fpt/tang-verilog/README.md

# tang-verilog

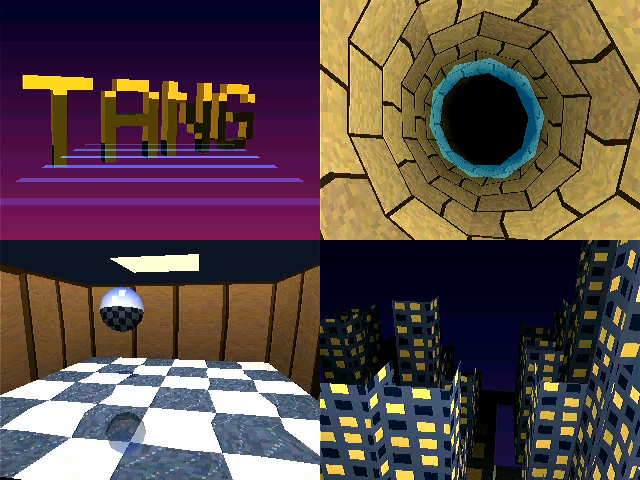
[picture p1: docs/images/g5_scenes.png]
3D GPU のビットストリームで描いた場面 (実機の HDMI キャプチャ): ロゴ、トンネル、映り込む玉の部屋、夜の街


Tang Nano 20K (Gowin GW2AR-18) と RP2350 で、レトロゲーム機の VDP のようなものを作るためのプロジェクトです。

- FPGA 側 (Tang Nano 20K): VDP 本体。今は HDMI (DVI) に 640x480@60Hz の映像を出す
- RP2350 側: ホスト CPU 役。SPI などで VDP にコマンドを送る (予定)

ツールはすべてオープンソースのものを Docker コンテナ内で動かします。ホストに必要なのは Docker と make だけです
(ボードへの書き込みだけは例外です。下の「書き込み」を参照)。

## ドキュメント

- [docs/SPECIFICATION.md](docs/SPECIFICATION.md): アプリケーション開発者向けの仕様 (接続、レジスタ、コマンド、データ形式、タイミング、制限)
- [docs/ARCHITECTURE.md](docs/ARCHITECTURE.md): 設計方針と今の実装 (レジスタバス、レジスタマップ、クロック、SDRAM)
- [docs/GPU_PLAN.md](docs/GPU_PLAN.md): SDRAM フレームバッファの tiny-GPU の開発計画 (ハーネスで検証しながら進める)
- [docs/WIRING.md](docs/WIRING.md): RP2350 と Tang Nano 20K の配線・SPI ピン割り当て
- [docs/DEVELOPMENT.md](docs/DEVELOPMENT.md): 開発環境の補足

## 状態

- 実機 (Tang Nano 20K + HDMI) で、SPI のハーネス (RP2040-Zero) からコマンド GPU (図形・BLIT)、ライン合成、タイル レイヤが動いている。
  すべて 参照モデル = Verilator = 実機 の CRC で確かめている ([docs/HARNESS.md](docs/HARNESS.md))
- 進み具合: コマンド GPU は [docs/GPU_PLAN.md](docs/GPU_PLAN.md) (M0〜M9 済み、M8 はやめた)、エミュレータ向けのタイル/スプライト エンジンは
  [docs/EMU_GPU_PLAN.md](docs/EMU_GPU_PLAN.md) (E1〜E4・E7 (Mode 7 と霧) 済み、次は E5 のホスト翻訳層)、
  [rs-kessel](https://github.com/fpt/rs-kessel) を載せる準備は [docs/KESSEL_ON_VDP.md](docs/KESSEL_ON_VDP.md) (K1〜K4 の VDP 側 = 8bpp の面・BLIT4・スプライトのセル順とバンク・STRETCH_BLIT・ライトマップ済み)
- 3D GPU (タイルベース、VDP を外した別のビットストリーム `make bitstream-gpu3d`。フラッシュに VDP と一緒に置き、`RECONFIG` で入れ替える) は [docs/GPU3D_PLAN.md](docs/GPU3D_PLAN.md) (G0 の骨格、G1 の三角形 (単色・Gouraud・Z)、G2 のタイルベースの遅延描画 (TBDR)、G3 のテクスチャ、G4 の半透明、G5 の場面 (ロゴ・トンネル・映り込む玉の部屋・夜の街、`harness.py demo <場面>`) 済み)
- 本番ホスト (RP2350) とのリンクは HSTX に決めた (EMU_GPU_PLAN.md の「本番のリンク」)。まだ作っていない

## ツール

| 用途 | ツール | 入手元 |
| --- | --- | --- |
| 論理合成 | Yosys + yosys-slang プラグイン (SystemVerilog フロントエンド) | [OSS CAD Suite](https://github.com/YosysHQ/oss-cad-suite-build) |
| 配置配線 | nextpnr-himbaechel (Gowin) | 同上 |
| ビットストリーム生成 | apicula (`gowin_pack`) | 同上 |
| シミュレーション | Icarus Verilog / Verilator / cocotb | 同上 |
| 書き込み | openFPGALoader | 同上 (ただしコンテナからは USB が使えない) |
| RP2350 ファームウェア | arm-none-eabi-gcc + pico-sdk 2.3.1 + picotool | Debian パッケージ / GitHub |

## セットアップ

```bash
make images
```

`docker/fpga` と `docker/pico` の 2 つのイメージを順番にビルドします (`make image-fpga` / `make image-pico` で個別にも可)。
FPGA 側は OSS CAD Suite (約 1GB) をダウンロードするので時間がかかります。
開発環境についての補足は [docs/DEVELOPMENT.md](docs/DEVELOPMENT.md) を参照してください。

### メモリについて

Docker Desktop の割り当てメモリが少ないと、イメージのビルド (特に picotool のコンパイル) でメモリが足りなくなることがあります。
2 つのイメージは並列ではなく 1 つずつビルドしてください。

## 使い方

```bash
make help
```

| コマンド | 内容 |
| --- | --- |
| `make lint` | Verilator で RTL を lint |
| `make sim` | `sim/tb_*.sv` を全部実行 (`SIM=verilator` で Verilator を使う)。VCD は `build/sim/` に出力 |
| `make sim-tb_tmds_encoder` | テストベンチを 1 つだけ実行 |
| `make render` | Verilator で映像出力を回し、各フレームを `build/render/frame_*.png` に保存 |
| `make bitstream` | 合成 → 配置配線 → VDP (`build/vdp/top.fs`) と 3D GPU (`build/gpu3d/top.fs`)。1 つだけなら `make bitstream-vdp` / `bitstream-gpu3d` |
| `make flash` | VDP をフラッシュの 0x000000、3D GPU を 0x100000 に (電源を入れると VDP。`harness.py reconfig` か、要るときに `harness.py` が自分で入れ替える) |
| `make prog` / `make prog-3d` | VDP / 3D GPU を SRAM に (開発中の確かめ) |
| `make bitstream-lcd` | 40 ピン RGB LCD (800x480) に HDMI と同じテストパターンを出す → `build/lcd/top_lcd.fs` (`make prog-lcd` で書き込み) |
| `make scenario SCENARIO=scenarios/m5_basic.json` | GPU のシナリオをシステム全体の RTL (Verilator) で走らせ、参照モデルの CRC と比べる。実機は `harness.py scenario` |
| `make render FREEZE=1` | アニメーションを止めた参照画像と各フレームの CRC (`frames.json`) を `build/render_frozen/` に (実機の `FRAME_CRC` と比べる) |
| `make render-lcd` | LCD 版の映像を `build/render_lcd/frame_*.png` に保存 |
| `make harness-fw` / `python3 tools/harness/harness.py <cmd>` | ハーネスの RP2 ブリッジとホストツール (`status` / `selftest` / `memtest` / `frametest` / `fbtest` / `prog` など)。詳細は [docs/HARNESS.md](docs/HARNESS.md) |
| `make prog` / `make flash` | Tang Nano 20K の SRAM / Flash に書き込み (書く前に、ハーネスのピンと衝突しないかを `pincheck-<設計>` が自動で検査する) |
| `make fw` | RP2350 ファームウェアをビルド (`firmware/build/vdp_host.uf2`) |
| `make shell` / `make shell-pico` | 各コンテナのシェルに入る |
| `make zip` | 別環境へ持っていくためのソース一式を `dist/<ディレクトリ名>.zip` に作成 (ホストの git と zip を使用) |

### 波形を見る

GTKWave は GUI ツールなので、macOS 上の Docker からは簡単には開けません。ローカルに何も入れずに見るなら
[Surfer のブラウザ版](https://app.surfer-project.org/) で `build/sim/*.vcd` を開いてください。

### 書き込み

macOS 上の Docker Desktop のコンテナからは USB デバイスにアクセスできないため、`make prog` だけはホストの `openFPGALoader` を使います。

```bash
brew install openfpgaloader
```

ホストに何も入れたくない場合は、Gowin 公式の Programmer を使う方法もあります。

RP2350 は BOOTSEL ボタンを押しながら USB 接続し、出てきたドライブに `firmware/build/vdp_host.uf2` をコピーすれば書き込めます (ツール不要)。
ボードを変えるときは `make fw PICO_BOARD=<ボード名>`、RISC-V コア (Hazard3) を使うときは `make fw PICO_PLATFORM=rp2350-riscv` です。

## ディレクトリ構成

```
docker/
  fpga/Dockerfile        FPGA ツール (OSS CAD Suite)
  pico/Dockerfile        RP2350 ツール (pico-sdk, picotool)
rtl/
  vdp/                   ベンダ非依存の RTL (シミュレーション可能)
    video_timing.sv      640x480@60Hz のタイミング生成
    vdp_core.sv          VDP コアの雛形 (カラーバー + 市松模様 + 跳ね回る四角)
    tmds_encoder.sv      DVI の TMDS エンコーダ
    vdp_video.sv         タイミング + コアをまとめたもの (MODE 0: 640x480 HDMI / 1: 800x480 LCD)
  gowin/                 Gowin のプリミティブを使う部分
    dvi_tx.sv            OSER10 + TLVDS_OBUF による DVI 送信
    top.sv               トップ (rPLL 126MHz → CLKDIV /5 → 25.2MHz)
    top_lcd.sv           RGB LCD 版トップ (rPLL 33MHz、800x480)
    blackbox/            Gowin プリミティブのブラックボックス定義 (合成専用)
constraints/
  tangnano20k.cst        ピン配置 (HDMI)
  tangnano20k_lcd.cst    ピン配置 (40 ピン RGB LCD)
sim/
  tb_*.sv                テストベンチ (Icarus Verilog / Verilator)
  verilator/render_main.cpp  フレームを画像に書き出すシミュレータ
firmware/                RP2350 ファームウェア (pico-sdk)
scripts/
  ppm2png.py             PPM → PNG 変換
```

## ハードウェアメモ (Tang Nano 20K)

| 信号 | ピン |
| --- | --- |
| 27MHz クロック | 4 |
| ボタン S1 / S2 (押下で 1) | 88 / 87 |
| LED0〜5 (負論理) | 15〜20 |
| HDMI CLK / D0 / D1 / D2 (P,N) | 33,34 / 35,36 / 37,38 / 39,40 |

- デバイス: `GW2AR-LV18QN88C8/I7` (nextpnr の family は `GW2A-18C`)
- 40 ピン RGB LCD の R/G 信号の一部 (33〜40) は HDMI と同じピンなので、HDMI と LCD は同時には使えません (別の `TARGET`)
- ピクセルクロックは 25.2MHz で、規格値の 25.175MHz からわずかにずれています (たいていのモニタは問題なく表示します)
