fpt/tang-verilog/docs/SPECIFICATION.md

# VDP 仕様書 (アプリケーション開発者向け)

Tang Nano 20K の VDP を、ホスト (RP2350 など) のプログラムから使うための仕様。[rs-kessel](https://github.com/fpt/rs-kessel) の VDP バックエンドなど、
コマンド列を作る側が参照することを想定している。設計の経緯は [ARCHITECTURE.md](ARCHITECTURE.md)、Kessel との対応は [KESSEL_ON_VDP.md](KESSEL_ON_VDP.md)。

この文書は E7 (Mode 7 と霧) までの RTL に合わせてある。正確な定義は RTL の先頭のコメント
([`gpu.sv`](../rtl/vdp/gpu.sv)、[`line_compositor.sv`](../rtl/vdp/line_compositor.sv)、[`tile_layer.sv`](../rtl/vdp/tile_layer.sv)、[`mode7_layer.sv`](../rtl/vdp/mode7_layer.sv)、
[`sprite_layer.sv`](../rtl/vdp/sprite_layer.sv)、[`vdp_regs.sv`](../rtl/vdp/vdp_regs.sv)) と、参照モデル [`gpu_model.py`](../tools/harness/gpu_model.py)。
食い違いがあれば RTL が正しい。参照モデルは RTL と同じ画をピクセル単位で作る (CRC が一致する) ので、ホスト側のテストの期待値に使える。

## 目次

1. 概要
2. ホストとの接続 (SPI)
3. レジスタ
4. コマンド
5. 合成のレジスタ (`REG_WRITE`)
6. データ形式
7. 合成 (レイヤと順位)
8. タイミング
9. 制限
10. 1 フレームの組み立て方
11. 検証の手がかり
12. 音 (PCM)
13. Mode 7 と霧
14. 3D GPU (別のビットストリーム)

---

## 1. 概要

- 論理画面は **320 x 240**。出力は縦横 2 倍の 640 x 480 @ 60Hz (HDMI / DVI)
- レイヤ: 背景色、**ビットマップ** (SDRAM のフレームバッファ 2 枚、RGB565 か 8bpp)、**タイルの面 A / B** とウィンドウ、**スプライト** 128 個。
  面 A は **Mode 7** (回転・拡大・遠近、13 章) にもできる。出力には行ごとの倍率と加算 (**霧**、フェード) を掛けられる
- ホストはレイヤのレジスタを書き、VRAM・パレット・OAM を書き、フレームバッファに**コマンドで描く**。VDP がピクセルを直接受け取ることはない
- 合成はライン単位。レジスタは**ラインの合成を始めるときに取り込む**ので、`WAIT_LINE` のあとのレジスタの変更はそのラインから効く (ラスター効果)

```text
ホスト ──SPI──► レジスタ ──► コマンド FIFO (512 ワード) ──► GPU ──► SDRAM (フレームバッファ・アセット)
                                                        │
                                                        ├──► VRAM (64KiB) / パレット (512 色) / OAM (128 個)
                                                        └──► 合成のレジスタ ──► ライン合成 ──► 640x480 出力
```

| 資源 | 大きさ | 書き方 |
| --- | --- | --- |
| SDRAM | 8MiB (2M ワード x 32bit) | `UPLOAD`、描くコマンド |
| VRAM | 16K ワード x 32bit (64KiB) | `VRAM_WRITE` |
| パレット | 512 エントリ x RGB565 | `PAL_WRITE` |
| OAM | 128 エントリ x 2 ワード | `OAM_WRITE` |
| ライトマップ | 40 x 30 セル (8 x 8 ピクセルごと) x RGB の倍率 | `LIGHT_WRITE` |
| 音 | 48kHz ステレオ 16bit、SDRAM の PCM のリング → 基板のアンプ (MAX98357A) | `UPLOAD` + `REG_WRITE` (12 章) |

ホストから SDRAM・VRAM・パレット・OAM を読み返す方法はない (SDRAM の 1 ワード読み出しはテスト用のレジスタにあるが、アプリケーションでは使わない)。

## 2. ホストとの接続 (SPI)

今のリンクは SPI。本番では HSTX (片方向の 4 ビット DDR) を足す予定で、そのときもコマンドの形式は同じ ([HARNESS2.md](HARNESS2.md))。

| 項目 | 値 |
| --- | --- |
| モード | mode 0 (CPOL 0, CPHA 0)、MSB first、8bit |
| CS | **正論理** (High で選択) |
| クロック | 8MHz まで実機で確認。FPGA が 63MHz でサンプリングするので上限は 10MHz 程度 |
| 電圧 | 3.3V |

配線は [WIRING.md](WIRING.md) (v1) と [HARNESS2.md](HARNESS2.md) (v2)。

### トランザクション

```text
書き込み: CS↑ [0 | addr(7)] [data] [data] ... CS↓     2 バイト目以降は addr, addr+1, ... へ
読み出し: CS↑ [1 | addr(7)] [xx]   [xx]   ... CS↓     2 バイト目以降に addr, addr+1, ... の値が返る
```

- **`0x30`〜`0x3F` はアドレスが進まない** (ポート)。`0x30` (`CMD`) には 1 回のトランザクションで何バイトでも続けて書ける
- 1 バイト目のあいだ、CIPO には同期確認用の `0xA5` が出る
- CS がバイトの途中で下がると `STATUS` のエラーが立つ (そのバイトは捨てられる)

### ほかの線

| 線 | 向き | 意味 |
| --- | --- | --- |
| IRQ | VDP → ホスト | 既定は VBLANK (`CONTROL` bit2 で有効)。`CONTROL` bit4 で **READY** (コマンド FIFO が半分以上空いている) に切り替わる。FPGA が未コンフィグのときは High に見える |
| VSYNC | VDP → ホスト | 垂直同期 (正論理、パルス中 High)。60Hz |
| HEARTBEAT | VDP → ホスト | フレームごとにトグル (30Hz)。リセット中は止まる。「FPGA が動いている」の判定に使う |
| RESET | ホスト → VDP | High でリセット (正論理)。全レジスタが既定に戻る。SDRAM・VRAM・パレット・OAM の中身は保証しない |

**IRQ / READY を信じる前に HEARTBEAT のトグル (か `ID` = `0x5A`) を確かめる** (未コンフィグ時やビットストリームの書き込み中も High なので)。

## 3. レジスタ

複数バイトの値はリトルエンディアン。

### システム (`vdp_regs`)

| アドレス | 名前 | R/W | 内容 |
| --- | --- | --- | --- |
| `0x00` | `STATUS` | R | bit0: VBLANK 中、bit1: エラー (SPI のフレームエラーなど。読むとクリア) |
| `0x01` | `CONTROL` | RW | bit2: IRQ 許可 (IRQ = VBLANK)、**bit3: 合成した画面を表示 (0 ならテストパターン)**、bit4: IRQ ピンを READY にする。bit0, bit1 は予約 (0 を書く)。既定 0 |
| `0x02` | `MARK_COUNT` | R | `MARK_CRC` を更新するたびに 1 増える |
| `0x04` | `FRAME_COUNT` | R | フレームカウンタの下位 8bit |
| `0x05`〜`0x08` | `FRAME_CRC` | R | 直前のフレームの表示の CRC-32 (11 章)。`0x05` を読んだ時点の値を取っておくので、`0x05` から 4 バイト続けて読む |
| `0x09` | `UNDERFLOW` | R | 合成が表示に間に合わなかったライン数 (飽和) |
| `0x0A`〜`0x0B` | `CRC_FRAME` | R | `FRAME_CRC` がリセットから何フレーム目の値か |
| `0x0C`〜`0x0F` | `MARK_CRC` | R | 印を付けたフレーム (`WAIT_VBLANK` の印) の CRC-32 |
| `0x7C` | `RECONFIG` | W | `0xA5` を書くと FPGA を再コンフィグする (設計が RECONFIG_N を Low にする)。フラッシュの multiboot で VDP (0x000000) と 3D GPU (0x100000) が入れ替わる。約 1.7 秒。ほかの値は何もしない |
| `0x7D` | `SCRATCH` | RW | 書いた値がそのまま読める (リンクの確認用) |
| `0x7E` | `ID` | R | `0x5A` |
| `0x7F` | `VERSION` | R | RTL の版 |

**起動したら `CONTROL` に `0x08` (READY を使うなら `0x18`) を書く。** 既定 (0) ではテストパターンが出ている。

`0x10`〜`0x2F` は SDRAM のテスト用 (アプリケーションでは触らない)。

### 音 (`audio_out`、読み出しだけ)

| アドレス | 名前 | R/W | 内容 |
| --- | --- | --- | --- |
| `0x50`〜`0x51` | `PCM_RD` | R | 再生した標本の数 (16bit で回る)。`0x50` を読んだ時点の値を取っておくので、`0x50` から 2 バイト続けて読む |
| `0x52` | `UNDERRUN` | R | 鳴らすときにデータがなく無音を出した標本の数 (飽和する。`AUDIO_CTRL` の clear で 0) |

### GPU (`gpu`)

| アドレス | 名前 | R/W | 内容 |
| --- | --- | --- | --- |
| `0x30` | `CMD` | W | コマンドのポート。書いたバイトを 4 つずつ (リトルエンディアン) 1 ワードにして FIFO に入れる |
| `0x40` | `GPU_STATUS` | R | bit0: 実行中 (FIFO にワードがある / コマンドを実行している)、bit1: エラー (知らないコマンドなど。読むとクリア)、bit2: FIFO があふれた (読むとクリア) |
| | | W | bit0 に 1: FIFO とワードの組み立てを空にする (実行中のコマンドはそのまま) |
| `0x41`〜`0x42` | `GPU_FREE` | R | FIFO の空き (ワード数)。ホストはこの数 x 4 バイトまで送ってよい |
| `0x44`〜`0x45` | `FB_BASE` | RW | 表示する面の先頭 (1KiB 単位、13bit)。既定 0 |
| `0x46`〜`0x47` | `DRAW_BASE` | RW | 描く面の先頭 (同じ単位)。既定 256 (= バイト `0x040000`) |
| `0x48`〜`0x49` | `BG_COLOR` | RW | 背景色 (RGB565) |
| `0x4A` | `LAYER_CTRL` | RW | 5 章と同じ |
| `0x4C`〜`0x4D` | `BITMAP_KEY` | RW | 5 章と同じ |

`BG_COLOR` `LAYER_CTRL` `BITMAP_KEY` はホストから直接も書けるが、ラインに合わせたいときはコマンドの `REG_WRITE` を使う (FIFO の順に効く)。

### 流量の制御

FIFO は 512 ワード。あふれたワードは捨てられ、`GPU_STATUS` bit2 が立つ。どちらかで制御する:

- **READY の線** (`CONTROL` bit4): High のあいだは 256 ワードまで送ってよい (High = 空きが半分以上)
- **`GPU_FREE` を読む**: 読んだ空き x 4 バイトまで送る

`WAIT_LINE` / `WAIT_VBLANK` / `SWAP` で GPU が待っているあいだも FIFO には積める。1 フレーム分 (目安 512 ワード以下) を先に送っておくと、
`WAIT_LINE` のあとの `REG_WRITE` が遅れない (8 章)。

## 4. コマンド

コマンドは 32bit ワードの列。先頭ワードの `[31:24]` がコマンド番号、引数のワードが続く。座標の組は `{y[15:0], x[15:0]}` (下位が x)。
FIFO の順に 1 つずつ実行する (描くコマンドも `WAIT_LINE` も同じ列に並ぶ)。

| 番号 | コマンド | ワード数 | 概要 |
| --- | --- | --- | --- |
| `0x00` | `NOP` | 1 | 何もしない |
| `0x01` | `CLEAR` | 1 | 描く面の全体を塗る |
| `0x02` | `FILL_RECT` | 3 | 矩形を塗る |
| `0x03` | `SWAP` | 1 | 表示する面と描く面を入れ替える |
| `0x04` | `UPLOAD` | 2 + n | SDRAM に n ワード書く |
| `0x05` | `POINT` | 2 | 1 ピクセル |
| `0x06` | `DRAW_LINE` | 3 | 線 |
| `0x07` | `CLIP` | 3 | クリップ矩形 |
| `0x08` | `BLIT` | 5 | SDRAM の画像を描く面に写す (8bpp では 4bpp のソースも) |
| `0x09` | `REG_WRITE` | 1 | 合成のレジスタ (5 章) |
| `0x0A` | `WAIT_LINE` | 1 | ライン n まで待つ |
| `0x0B` | `WAIT_VBLANK` | 1 | 次のフレームのライン 0 まで待つ (印を付けられる) |
| `0x0C` | `VRAM_WRITE` | 2 + n | VRAM に n ワード |
| `0x0D` | `PAL_WRITE` | 2 + ⌈n/2⌉ | パレットに n 色 |
| `0x0E` | `STRETCH_BLIT` | 7 | `BLIT` の拡大縮小版 (最近傍) |
| `0x0F` | `OAM_WRITE` | 2 + n | OAM に n ワード |
| `0x10` | `LIGHT_WRITE` | 2 + n | ライトマップに n セル |
| ほか | — | 1 | エラーを立て、1 ワードのコマンドとして読み飛ばす |

### 色

描くコマンドの色は、面の形式 (`BITMAP_FMT`、5 章) で意味が変わる。

- **RGB565** (`BITMAP_FMT` = 0): `[15:0]` が RGB565 の色
- **8bpp** (`BITMAP_FMT` = 1): `[7:0]` がパレットの番号 (0..255)。`[15:8]` は無視 (`BLIT` の 4bpp では `[11:8]` がバンク)

`BITMAP_FMT` は描くコマンドには**すぐ**効く。面の中身の形式を覚えているわけではないので、描くときと表示するときの形式をホストが揃える。

### 各コマンド

**`CLEAR`** `[0x01, -, color]`
描く面の 320 x 240 全体を塗る。**クリップ矩形は効かない。**

**`FILL_RECT`** `[0x02, -, color]` `{y, x}` `{h, w}`
x, y, w, h は**符号なし**。画面の外にはみ出した部分とクリップ矩形の外は描かない。w = 0 か h = 0 なら何もしない。
画面の外 (負の座標) から始まる矩形は、ホストが切ってから送る。

**`SWAP`** `[0x03]`
`FB_BASE` と `DRAW_BASE` を入れ替える。表示側が新しい `FB_BASE` を取り込む (次のフレームのライン 0 の合成を始める) まで、**後続のコマンドを待たせる**。
なので `SWAP` のあとのコマンドは、前の表示面 (= 新しい描く面) を安全に描ける。

**`UPLOAD`** `[0x04, n(24bit)]` `addr` `data × n`
SDRAM のワードアドレス `addr` (21bit) から n ワード書く。1 ワードずつ書くので速くない (8 章)。アセットは起動時にまとめて送る。

**`POINT`** `[0x05, -, color]` `{y, x}`
x, y は**符号付き** 16bit。クリップ矩形の中なら 1 ピクセル描く。

**`DRAW_LINE`** `[0x06, -, color]` `{y0, x0}` `{y1, x1}`
符号付き。ブレゼンハムで両端を含めて描く。画面の外から始まる線もよい (クリップ矩形の外のピクセルは飛ばす)。
傾きの規則は `err = dx + dy` (dy は負)、`e2 = 2 err`、`e2 >= dy` で x、`e2 <= dx` で y を進める (参照モデルの `bresenham()`)。

**`CLIP`** `[0x07]` `{y0, x0}` `{y1, x1}`
符号なし、両端を含む。以降の `FILL_RECT` `POINT` `DRAW_LINE` `BLIT` をこの矩形の中だけにする。画面の外は画面の端に丸める。
x0 > x1 などなら何も描かなくなる。既定は画面全体 (`0,0`〜`319,239`)。

**`BLIT`** `[0x08, flags(8), key(16)]` `src` `{h, w}` `{y, x}` `stride`
SDRAM のワードアドレス `src` にある w x h の画像を、描く面の (x, y) (符号付き) に写す。`stride` はソースの 1 行のワード数 (下位 16bit)。

| flags | 意味 |
| --- | --- |
| bit0 | 透過: 透過色 (下) のピクセルを書かない |
| bit1 | 左右反転 |
| bit2 | 上下反転 |
| bit3 | 4bpp のソース (BLIT4)。**8bpp のときだけ**。RGB565 で立てるとエラーになり何も描かない |

| 面の形式 | ソース | 1 ワードのピクセル | 書く値 | 透過色 |
| --- | --- | --- | --- | --- |
| RGB565 | RGB565 | 2 (下位 16bit が左) | そのまま | `key` (RGB565) |
| 8bpp | 8bpp | 4 (バイト i がピクセル i) | そのまま | `key[7:0]` |
| 8bpp | 4bpp (bit3) | 8 (ピクセル i は `[31-4i -: 4]`) | `{key[11:8], ピクセル}` | 値 0 |

- ソースの各行は**ワードの先頭から始まる** (行の途中のピクセルから切り出すときは、`src` をワード単位で、左端をワードの境目に揃える)
- w は 512 まで (越えるとエラー)。h は 240 を越えてもよい (はみ出しは描かない)
- 4bpp のソースはタイルの 1 行と同じ並び。タイルのシート (6 章) を SDRAM に `UPLOAD` すれば、タイル t は `src = base + 8t`、`stride = 1`、`w = h = 8`
- ソースは SDRAM だけ。VRAM・描く面と重なるソースの動きは決めていない (重ねない)
- クリップ矩形と画面の外は描かない

**`STRETCH_BLIT`** `[0x0E, flags(8), key(16)]` `src` `{dh, dw}` `{y, x}` `{sw, stride}` `sx_step` `sy_step`
SDRAM の画像を拡大縮小して、描く面の (x, y) (符号付き) に dw x dh で描く (最近傍)。flags・key・ソースの形式・透過・クリップは `BLIT` と同じ。

- `sw` はソースの幅 (ピクセル、ソースの 1 行を読む長さ)、`stride` は 1 行のワード数
- `sx_step` / `sy_step` は 16.16 の固定小数点で、描く 1 ピクセルあたりのソースのピクセル数 (= ソースの大きさ / 描く大きさ。**割り算はホストが行う**)
- 描くピクセル (i, j) (反転の前、0 から) が拾うソースは、列 `((sx_step >> 1) + i * sx_step) >> 16`、行 `((sy_step >> 1) + j * sy_step) >> 16`
  (32bit で計算する。半ピクセルずらしてピクセルの中心で拾うので、縮小で片寄らない)。左右反転は描く列を右から、上下反転は描く行を下から並べる
- **拾うソースの列は `sw` より小さくなるように step を選ぶ** (`sx_step = sw * 65536 / dw` の切り捨てなら必ず収まる)。越えたときの値は決まっていない。
  行は `stride` で進むだけなので、ソースの高さはホストが守る
- 上限: dw, dh は 1024 まで。`sw` はソースの 1 行が 256 ワードに収まる大きさまで (RGB565 で 512、8bpp で 1024、4bpp で 2048)。越えるとエラーで何も描かない
- クリップの外の行は読まない (その分速い)。同じソースの行が続く (拡大する) ときは読み直さない
- Kessel の `spr_scaled(id, x, y, scale)` は、タイル t を `src = base + 8t`、`stride` 1、`sw` 8、`dw = dh = 8 * scale` (切り捨て)、`step = 8 * 65536 / dw` の 4bpp の `STRETCH_BLIT` にする

**`REG_WRITE`** `[0x09, reg(8), value(16)]`
合成のレジスタ `reg` に値を書く (5 章)。知らない番号はエラー。

**`WAIT_LINE`** `[0x0A, -, n(8)]`
以降のコマンドを、ライン n の合成が始まる直前 (ライン n-1 の合成が始まったところ) まで待たせる。
**これより後の `REG_WRITE` はライン n から効く。** n = 0 は `WAIT_VBLANK` と同じ。n は 0..239。
すでにライン n を過ぎていたら、次のフレームのライン n まで待つ。

**`WAIT_VBLANK`** `[0x0B, -, mark(1)]`
`WAIT_LINE 0` と同じ: ライン 239 の合成が始まった直後まで待つ (以降の `REG_WRITE` は次のフレームのライン 0 から効く)。
そこからライン 0 の合成までは約 1.5ms (8 章)。
`[0]` = 1 なら次のフレームに印を付け、その CRC を `MARK_CRC` に残す (11 章)。

**`VRAM_WRITE`** `[0x0C, n(24)]` `addr` `data × n`
VRAM のワードアドレス `addr` から n ワード (16K ワードで折り返す)。1 クロック 1 ワード。

**`PAL_WRITE`** `[0x0D, n(24)]` `index` `data × ⌈n/2⌉`
パレットの `index` (0..511) から n 色。1 ワードに 2 色 (下位 16bit が先)。n が奇数なら最後のワードの上位は使わない。512 で折り返す。

**`OAM_WRITE`** `[0x0F, n(24)]` `addr` `data × n`
OAM のワードアドレス `addr` (エントリ k はワード 2k と 2k+1) から n ワード (256 ワードで折り返す)。形式は 6 章。

**`LIGHT_WRITE`** `[0x10, n(24)]` `addr` `data × n`
ライトマップのセル `addr` (= `cy * 40 + cx`) から n セル (2048 で折り返す。1,200 以上は使われない)。1 ワードに 1 セル:
`[5:0]` R、`[13:8]` G、`[21:16]` B の倍率 (0..63、16 = 1 倍)。全体は 1 回の `LIGHT_WRITE` (1,200 ワード) で書ける。使い方は 7 章の「ライトマップ」。

VRAM・パレット・OAM・ライトマップの書き込みは**すぐ**効く (ラインに合わせない)。表示中に書くと、そのフレームの途中から変わる (8 章)。

## 5. 合成のレジスタ (`REG_WRITE`)

どれもラインの合成を始めるときに取り込む。値は各レジスタの幅に切る。

| 番号 | 名前 | 幅 | 既定 | 内容 |
| --- | --- | --- | --- | --- |
| 0 | `BG_COLOR` | 16 | 0 | 背景色 (**RGB565**、パレットの番号ではない)。どのレイヤも書かなかったピクセルの色 |
| 1 | `LAYER_CTRL` | 6 | 1 | bit0: ビットマップ、bit1: ビットマップの透過色を有効、bit2: 面 A (とウィンドウ)、bit3: スプライト、bit4: 面 B、bit5: ライトマップを掛ける |
| 2 | `BITMAP_KEY` | 16 | 0 | ビットマップの透過色。RGB565 の面では色、8bpp の面では `[7:0]` がパレットの番号 |
| 3 | `TILE_SCROLL_X` | 10 | 0 | 面 A の横スクロール (ピクセル) |
| 4 | `TILE_SCROLL_Y` | 10 | 0 | 面 A の縦スクロール |
| 5 | `TILE_MAP_BASE` | 14 | 0 | 面 A のマップの VRAM のワードアドレス |
| 6 | `TILE_PAT_BASE` | 14 | 0 | 面 A (とウィンドウ) のタイルの VRAM のワードアドレス |
| 7 | `TILE_CTRL` | 8 | 0 | 面 A の設定 (6 章の「面の設定」) |
| 8 | `BITMAP_RANK` | 3 | 1 | ビットマップの順位 (7 章)。0 なら書かない |
| 9 | `SPR_PAT_BASE` | 14 | 0 | スプライトのタイルの VRAM のワードアドレス |
| 10 | `SPR_BANK` | 4 | 0 | `[2:0]` スプライトのパレットのバンク (64 色単位)。`[3]` = 1 ならスプライトごとのバンク (OAM ワード 1 の `[19:16]`) を使う |
| 11 | `SPR_LINE_PX` | 10 | 320 | 1 ラインのスプライトのピクセル数の上限 (8 の倍数に切り捨て) |
| 12〜16 | `TILEB_SCROLL_X` `TILEB_SCROLL_Y` `TILEB_MAP_BASE` `TILEB_PAT_BASE` `TILEB_CTRL` | | 0 | 面 B (面 A と同じ形) |
| 17 | `WIN_H` | `[7]`, `[4:0]` | 0 | ウィンドウの横: `[7]` = 1 なら右側、位置 = `[4:0]` x 16 ピクセル |
| 18 | `WIN_V` | `[7]`, `[4:0]` | 0 | ウィンドウの縦: `[7]` = 1 なら下側、位置 = `[4:0]` x 8 ライン |
| 19 | `WIN_MAP_BASE` | 14 | 0 | ウィンドウのマップ (64 x 32、スクロールしない) |
| 20 | `HSCROLL_MODE` | 2 | 0 | 横スクロールの表: 0 なし (レジスタ)、1 画面全体、2 8 ラインごと、3 ラインごと |
| 21 | `HSCROLL_BASE` | 14 | 0 | 横スクロールの表の VRAM のワードアドレス |
| 22 | `BITMAP_FMT` | 1 | 0 | ビットマップの形式: 0 = RGB565、1 = 8bpp。描くコマンドにはすぐ、表示には次のラインから |
| 23 | `AUDIO_CTRL` | 2 | 0 | `[0]` 音を出す (アンプも有効)、`[1]` に 1: `PCM_RD`・`UNDERRUN`・先読みを空にする (12 章) |
| 24 | `PCM_BASE` | 13 | `0x1FE0` | PCM のリングの SDRAM の先頭 (256 ワード = 1KiB 単位)。既定は SDRAM の最後の 32KiB |
| 25 | `PCM_SIZE` | 4 | 11 | リングの大きさ = `1 << n` ワード (標本) |
| 26 | `PCM_WR` | 16 | 0 | ホストが書いた標本の数 (16bit で回る)。`UPLOAD` のあとに書く |

| 32〜50 | `M7_SEL` 〜 `LINE_FX_BASE` | | | Mode 7 と霧 (13 章) |

23〜26 はラインに合わせず、実行したときに効く。ほかの番号 (27〜31、51〜) はエラー。

### ウィンドウ

メガドラと同じ規則。ラインが縦の範囲 (`WIN_V`: 下側なら `line >= 位置`、上側なら `line < 位置`) に入ればライン全体がウィンドウ、
入らなければ横の範囲 (`WIN_H`: 右側なら `x >= 位置`、左側なら `x < 位置`) だけ。ウィンドウの中では面 A を描かず、代わりに
`WIN_MAP_BASE` の 64 x 32 のマップをスクロールなしで描く。タイルの場所・パレットのバンク・エントリの並びは面 A のもの、順位も面 A と同じ。
`WIN_H` = `WIN_V` = 0 ならウィンドウなし。

### 横スクロールの表

`HSCROLL_MODE` が 0 でなければ、ラインごとに VRAM の `HSCROLL_BASE + 番号` の 1 ワードを読み、`[25:16]` を面 A、`[9:0]` を面 B の値にする。
番号はモード 1: 0、2: `line & ~7`、3: `line`。**値の向きはメガドラと同じで、正の値で面が右に動く** (`scroll_x = -値`)。
このとき `TILE_SCROLL_X` / `TILEB_SCROLL_X` は使わない (縦スクロールはレジスタのまま)。

## 6. データ形式

### フレームバッファ (SDRAM)

1 ラインは SDRAM の 1 行 (256 ワード = 1KiB) に置く。面の先頭を `base` (1KiB 単位) とすると、ライン y はワードアドレス `(base + y) * 256` から。

| 形式 | 1 ワードのピクセル | ピクセル x の場所 | 1 ラインのワード数 |
| --- | --- | --- | --- |
| RGB565 | 2 | ワード `x / 2` の `[16 (x % 2) +: 16]` | 160 |
| 8bpp | 4 | ワード `x / 4` の `[8 (x % 4) +: 8]` | 80 |

RGB565 は `{R[4:0], G[5:0], B[4:0]}`。8bit への広げ方は上位ビットの繰り返し (`R8 = {R5, R5[4:2]}` など)。

SDRAM の使い方 (決まりではなく既定の値):

| バイトアドレス | 用途 |
| --- | --- |
| `0x000000` | 面 0 (`FB_BASE` の既定 0) |
| `0x040000` | 面 1 (`DRAW_BASE` の既定 256) |
| `0x080000`〜 | 空き (アセット: BLIT のソース、4bpp のタイルのシートなど) |
| `0x7F8000`〜`0x7FFFFF` | 音の PCM のリング (`PCM_BASE` の既定。2048 標本なら 8KiB) |

ワードアドレスは 21bit (`0`〜`0x1FFFFF`)。面は 240 行 = 240KiB を使う。

### パレット

512 エントリ x RGB565。全レイヤで共有する。

| 使う側 | 番号 |
| --- | --- |
| タイルの面 | `{TILE_CTRL[6:4] (バンク), エントリのパレット (2bit), ピクセルの値 (4bit)}` = バンク x 64 + パレット x 16 + 値 |
| スプライト | `{SPR_BANK[2:0], エントリのパレット (2bit), ピクセルの値}`。`SPR_BANK[3]` = 1 なら `{0, スプライトのバンク (4bit), ピクセルの値}` (0..255、8bpp・BLIT4 と同じ番号) |
| 8bpp のビットマップ | 0..255 (ピクセルの値そのまま) |
| BLIT4 | 描く値 `{バンク (4bit), ピクセル}` が 8bpp の番号になる (0..255) |

### タイル (VRAM)

8 x 8 ピクセル、4bpp。1 行が 1 ワードで、**ピクセル i (左から) は `[31-4i -: 4]`** (上位のニブルが左)。タイル t の行 r はワード `pat_base + 8t + r`。
ピクセルの値 0 は透明。タイル番号は 11bit (0..2047)。VRAM は 16K ワードなので、マップと合わせて 64KiB に収める。

同じ形式のデータを SDRAM に置けば BLIT4 のソースになる (タイル 1 個 = 8 ワード、stride 1)。

### マップのエントリ (面 A / B / ウィンドウ)

16bit、1 ワードに 2 つ。

| ビット | 意味 |
| --- | --- |
| `[10:0]` | タイル番号 |
| `[11]` | 左右反転 |
| `[12]` | 上下反転 |
| `[14:13]` | パレット (0..3) |
| `[15]` | 優先度 (7 章) |

列 c、行 r のエントリは `map_base + (r * 幅 + c) / 2` の、偶数の列なら下位 16bit (面の設定 `[7]` = 1 なら上位 = メガドラの並び)。

### 面の設定 (`TILE_CTRL` / `TILEB_CTRL`)

| ビット | 意味 |
| --- | --- |
| `[1:0]` | マップの幅: 0 = 32、1 = 64、2 = 128 タイル |
| `[3:2]` | 高さ: 0 = 32、1 = 64、2 = 128、3 = 28 タイル (このときは scroll_y < 224) |
| `[6:4]` | パレットのバンク (64 色単位) |
| `[7]` | エントリの並び: 0 = 下位が偶数の列、1 = 上位が偶数の列 (メガドラの VRAM をビッグエンディアンの 32bit で読んだ並び) |

画面のピクセル (x, line) は、マップのピクセル `((x + scroll_x) mod 幅, (line + scroll_y) mod 高さ)`。**面は折り返して画面全体を覆う**。

### OAM (スプライト)

128 エントリ、エントリ n はワード 2n (ワード 0) と 2n+1 (ワード 1)。

| ワード | ビット | 意味 |
| --- | --- | --- |
| 0 | `[9:0]` | x (符号付き 10bit、画面の左端が 0) |
| 0 | `[25:16]` | y (符号付き 10bit) |
| 0 | `[27:26]` | 幅 - 1 (タイル、1〜4) |
| 0 | `[29:28]` | 高さ - 1 (タイル、1〜4) |
| 0 | `{[10], [30]}` | セルの並び順 (下) |
| 0 | `[31]` | 有効 |
| 1 | `[15:0]` | マップのエントリと同じ形 (先頭のタイル、左右反転、上下反転、パレット、優先度) |
| 1 | `[19:16]` | スプライトごとのバンク (`SPR_BANK[3]` = 1 のときだけ使う。そのときエントリのパレット `[14:13]` は使わない) |

ほかのビット (ワード 0 の `[15:11]`、ワード 1 の `[31:20]`) は 0 にする (将来使う)。

セルの並び順 (スプライトの中の列 c、行 r のタイル):

- 0: 列優先 (メガドラ) — `先頭 + c * 高さ + r`
- 1: 16 タイル幅の表 (SNES) — `{先頭[10:4] + r, 先頭[3:0] + c}` (列は表の行の中で折り返す)
- 2: 行優先、ストライドはスプライトの幅 (Kessel の `sprn`) — `先頭 + r * 幅 + c`
- 3: 予約 (今は 2 と同じ。使わない)

左右反転はタイルの列の順番とタイルの中のピクセルの両方を、上下反転は行の順番とタイルの中の行の両方を逆にする。

## 7. 合成 (レイヤと順位)

ピクセルごとに、順位の一番高いレイヤの色が出る。どのレイヤも書かなかったところは `BG_COLOR`。

| 順位 | レイヤ |
| --- | --- |
| 0 | 背景色 |
| 1 | 面 B (低優先) |
| 2 | 面 A (低優先) とウィンドウ。Mode 7 (EXTBG なら `[7]` が 0 のピクセル) |
| 3 | スプライト (低優先) |
| 4 | 面 B (高優先) |
| 5 | 面 A (高優先) とウィンドウ。Mode 7 の EXTBG で `[7]` が 1 のピクセル |
| 6 | スプライト (高優先) |
| `BITMAP_RANK` | ビットマップ (0〜7) |

- 優先度はタイルのエントリ / OAM の `[15]`
- **同じ順位なら、先に書いたほうが残る**。書く順は スプライト → 面 B → 面 A → ウィンドウ → ビットマップ。
  なので `BITMAP_RANK` = 6 は、すべての面より上で、高優先のスプライトより下 (低優先のスプライトよりは上) になる
- スプライト同士は優先度によらず **OAM の前のエントリが勝つ** (メガドラ・SNES と同じ)
- タイル・スプライトのピクセルの値 0 は透明。ビットマップは `LAYER_CTRL` bit1 が立っているとき、透過色 (`BITMAP_KEY`) のピクセルが透明

よく使う組み合わせ:

| 狙い | 設定 |
| --- | --- |
| 面の上に即時描画、その上にハードスプライト (Kessel の 3 段) | `BITMAP_RANK` = 6、透過あり、スプライトは高優先 |
| ビットマップを一番上 (HUD) | `BITMAP_RANK` = 7 |
| ビットマップを一番下 (背景画) | `BITMAP_RANK` = 1 (既定)、面は透明なところから下が見える |

### ライトマップ

`LAYER_CTRL` bit5 が立っているラインでは、合成した色 (背景色を含む、レイヤによらず全部) に、ピクセル (x, y) のセル `(x / 8, y / 8)` の倍率を掛ける。
各色 c (R5・G6・B5) と倍率 L (0..63) について `min(最大値, (c * L) >> 4)`。L = 16 で元の色、0 で黒、32 で 2 倍 (最大値で切れる)。

- セルの解像度は 8 ピクセル。光の境目はセルの境目で段になる (補間はしない)
- 倍率は R, G, B で別々なので、色の付いた光 (`light(…, r, g, b)`) もそのまま表せる
- Kessel の倍率 (64 = 1 倍、8bit) からは `>> 2` で直す
- ラインごとに切り替えられる (HUD の行だけ光なし、など)。合成の時間は増えない
- 行の倍率 `LINE_MUL` と加算 `LINE_ADD` (霧、13 章) と同じ段で掛かる。倍率はセルの倍率 x 行の倍率 (63 で切る)

## 8. タイミング

### 映像

| 項目 | 値 |
| --- | --- |
| 出力 | 640 x 480 @ 60Hz (ピクセルクロック 25.2MHz)、1 フレーム 525 ライン x 800 クロック = 16.67ms |
| 論理ライン | 出力 2 ライン = 63.5us |
| VBLANK | 出力ライン 480〜524 (45 ライン = 1.43ms)。`STATUS` bit0、IRQ |
| GPU・SDRAM のクロック | 63MHz |

### 合成

- 論理ライン n は、ライン n-1 を表示しているあいだ (63.5us = 63MHz で 4,000 クロック) に合成する。ライン 0 は VBLANK の最後から 2 本目の出力ラインで合成する
- レジスタは合成を始めるときに取り込む。`WAIT_LINE n` が終わるのはライン n-1 の合成が始まった直後なので、そのあと FIFO にある `REG_WRITE` は数クロックで実行され、ライン n に間に合う
- **FIFO が空で、`WAIT_LINE` のあとの `REG_WRITE` がまだ届いていないと、効くラインがずれる**。ラスター効果を使うフレームは、そのフレームのコマンドを先に送っておく
- 1 ラインの合成の重さ (63MHz のクロック数、締め切り 4,000): スプライトの OAM の走査 約 130 + 描くスプライトの列ごとに約 10、面 1 枚 約 450、
  RGB565 のビットマップ 約 170、8bpp のビットマップ 約 410、**Mode 7 の面 A 約 645** (タイルの面 A の約 450 の代わり)。
  Mode 7 のラインの先頭の計算 (約 190) はスプライト・面 B のパスと同時に動くので、ふつうは時間に乗らない。行ごとの表 (Mode 7 か霧) を使うラインは +3。
  今あるシナリオの最悪は 3,126 (`e7_mode7` の 5 つ目: スプライトの上限 1023 ピクセル + 面 B + Mode 7 + 8bpp のビットマップ)。
  間に合わなかったラインは `UNDERFLOW` に数える

### 描くコマンドの速さ (目安)

GPU は 63MHz。書き込みは 1 行の中で 64 ワードずつのバースト。表示の読み出しが優先なので、多少待たされる。

| コマンド | 目安 |
| --- | --- |
| `CLEAR` (RGB565) | 約 0.7ms (38,400 ワード) |
| `CLEAR` (8bpp) | 約 0.35ms (19,200 ワード) |
| `FILL_RECT` | 1 行あたり 数十クロック + ワード数 |
| `BLIT` | 1 行あたり ソースの読み (数十クロック + ソースのワード数) + 書き (数十クロック + 描くワード数)。8x8 の BLIT4 で 数百クロック |
| `STRETCH_BLIT` | 描く 1 行あたり 描くピクセル数 + 書き (数十クロック + 描くワード数) + ソースの行が変わったときだけ読み。8bpp の 160x120 → 320x240 で 1.7ms (実機) |
| `DRAW_LINE` / `POINT` | 1 ピクセル 10 クロック程度 (クリップの外は 2 クロック) |
| `UPLOAD` | 1 ワード 10 クロック程度 |
| `VRAM_WRITE` / `PAL_WRITE` / `OAM_WRITE` | 1 ワード 3 クロック程度 (FIFO から読む速さ) |

リンクの速さ: SPI 8MHz で約 1MB/s = 1 フレーム約 16KiB (4,000 ワード)。1 フレームのコマンドはこれに収める。

### 書き込みと表示の関係

- フレームバッファ: 描く面 (`DRAW_BASE`) に描き、`SWAP` で表示を切り替える (切り替わるのは次のフレームのライン 0)。表示中の面に描くとちらつく
- VRAM・パレット・OAM: すぐ効く。フレームの途中で書き換えるとその場から変わる。表示を乱したくなければ `WAIT_VBLANK` のあとに書く。
  `WAIT_VBLANK` が終わるのはライン 239 の合成が始まった直後 (出力ライン 476) で、そこからライン 0 の合成 (出力ライン 523) までは約 1.5ms (約 90,000 クロック)。
  GPU は 1 ワード 3 クロックで書けるので、量の制限は実際にはリンクの速さ (SPI 8MHz で 1.5ms に約 1.5KiB。先に FIFO に積んでおけば 512 ワードまでは待たずに実行される)
- ただし `WAIT_VBLANK` の直後は、ライン 239 (今のフレームの最後のライン) の合成がまだ数十 µs 続いている。直後の書き込みはそのラインに混ざることがある
  (M9 のデモは `WAIT_VBLANK` の直後に OAM を書いている。影響しうるのは最後の 1 ラインだけ)

## 9. 制限

### 画面・レイヤ

- 論理画面は 320 x 240 固定。半透明はない。レイヤの回転・拡大は面 A の Mode 7 だけ (ほかは `STRETCH_BLIT` で描く面に描く)。
  色の加算は行ごとの `LINE_ADD` だけ (ピクセルごと・レイヤごとの加算・減算はない)
- タイルの面は 2 枚 (A / B) + ウィンドウ。縦スクロールは面ごとに 1 つ (列ごとの縦スクロールはない)。ウィンドウは面 A の代わりにだけ出せる
- 面は必ず折り返して画面全体を覆う (マップの一部だけを出すには、使わないところをタイル 0 にする)
- パレットは 512 色。タイル・スプライト・8bpp のビットマップで共有する
- ライトマップは 8 x 8 ピクセルのセル単位 (ピクセル単位の光はない)。倍率は 4 倍未満 (63 / 16) まで
- Mode 7 は面 A の代わり (面 B と合わせて 2 面まで)。Mode 7 のあいだウィンドウは描かない。マップは 128 x 128 セル、タイルは 256 個まで

### スプライト

- 128 個。大きさは 1〜4 x 1〜4 タイル (8〜32 ピクセル)
- 1 ラインの上限は `SPR_LINE_PX` / 8 列 (タイルの列の数)。**画面の外の列も数える** (メガドラと同じ)。上限を越えたスプライトの残りの列と、後ろのエントリは描かない。
  設定できるのは 1023 ピクセル (127 列) まで。どの値でも、面 2 枚とビットマップを合わせて合成は締め切りに間に合う
- `SPR_BANK[3]` = 0 のとき、1 つのスプライトが使えるパレットは `SPR_BANK` の 64 色 (4 パレット) だけ。`SPR_BANK[3]` = 1 なら
  スプライトごとに 16 色のバンク 16 個 (パレット 0..255) から選べる。どちらのモードかは全スプライト共通 (ラインごとには切り替えられる)

### ビットマップと描くコマンド

- `FILL_RECT` の座標は符号なし (負の座標は使えない。ホストが切る)。`POINT` `DRAW_LINE` `BLIT` は符号付き
- `CLEAR` はクリップ矩形を無視する
- `BLIT` の幅は 512 ピクセルまで。ソースは SDRAM だけで、各行はワードの境目から始まる
- `STRETCH_BLIT` は最近傍だけ (補間はない)。描く大きさは 1024 x 1024 まで
- 4bpp のソース (BLIT4) は 8bpp の面にだけ描ける
- 塗りつぶしの三角形・円はない (線と矩形で組む)
- 描く面の形式は `BITMAP_FMT` の今の値で決まる。面が RGB565 か 8bpp かは VDP は覚えていない

### リンク

- コマンドの流れは片方向。結果 (描き終わったか) は `GPU_STATUS` bit0 か FIFO の空きで知る
- ホストから SDRAM・VRAM・パレット・OAM は読めない

### 音

- 48kHz・ステレオ 16bit だけ (標本化周波数は変えられない)。基板のアンプ (MAX98357A) はモノラルで、左右どちらを鳴らすかは基板の配線による。同じ値を左右に入れる
- ミキサーや音源はない。ホストが混ぜた PCM を送る

## 10. 1 フレームの組み立て方

```text
起動:
  CONTROL = 0x18                       合成した画面を表示、IRQ ピンを READY に
  UPLOAD / VRAM_WRITE / PAL_WRITE      アセット (BLIT のソース、タイル、マップ、パレット)
  REG_WRITE                            面・スプライトの設定、BITMAP_FMT など

毎フレーム:
  WAIT_VBLANK                          ここからは次のフレームのライン 0 の前
  REG_WRITE (ライン 0 の値)              スクロール、背景色など
  OAM_WRITE / VRAM_WRITE (マップの差分)  VBLANK のあいだに
  SWAP                                 前のフレームで描いた面を表示に (次のフレームのライン 0 から)。
                                       表示が取り込むまで後続は待つので、ここから描く面は空いている
  [WAIT_LINE n + REG_WRITE ...]         ラスター効果 (使うなら)
  CLEAR / FILL_RECT / DRAW_LINE / BLIT  次のフレームの画を描く面に
  UPLOAD (PCM) + REG_WRITE PCM_WR       音を 800 標本 (1 フレーム分) 足す (12 章)
```

- ラスター効果 (`WAIT_LINE`) と描くコマンドは同じ列に並ぶ。`WAIT_LINE` で待つあいだは描画も止まるので、
  描くコマンドは最後の `WAIT_LINE` のあとか、`WAIT_LINE` のあいだに収まる量を置く ([`demo.py`](../tools/harness/demo.py) の並べ方が例)
- 1 フレームのコマンドは FIFO (512 ワード) と READY で流す。READY が落ちたら待つ
- 8bpp で、面 (タイル) と即時描画を重ねるフレームは、`CLEAR` を透過色で行い `LAYER_CTRL` bit1 を立てる。重ねないフレームは透過を切り、
  `CLEAR` を普通の色で (KESSEL_ON_VDP.md の 2 章)

## 11. 検証の手がかり

- **`FRAME_CRC`**: 直前のフレームの表示 (640 x 480 の DE 中のピクセルを R, G, B の順のバイト列にしたもの) の CRC-32。
  Python の `zlib.crc32` と同じ (IEEE 802.3)。論理画面 320 x 240 の RGB565 の画からは
  `fbmodel.expected_crc(img565)` (縦横 2 倍、565 → 888 の広げ方込み) で同じ値が作れる
- **印**: `WAIT_VBLANK` の `[0]` = 1 で次のフレームに印を付けると、そのフレームの CRC が `MARK_CRC` に残り、`MARK_COUNT` が 1 増える。
  ラインごとにレジスタを変えたフレームを比べるのに使う
- **参照モデル**: [`gpu_model.py`](../tools/harness/gpu_model.py) の `Model` にコマンドのワード列を `run()` で渡すと、表示される画 (`displayed565()`)
  と印を付けたフレーム (`marked565()`) を作る。RTL と同じ CRC になる。ホスト側 (Kessel のソフトラスタライザ) との突き合わせに使える
- **シナリオ**: `scenarios/*.json` は、同じコマンド列を参照モデル・Verilator・実機で走らせて CRC を比べるためのもの ([HARNESS.md](HARNESS.md))。
  K1 の機能は `scenarios/k1_8bpp.json`

## 12. 音 (PCM)

- **形式**: 48kHz、ステレオ 16bit (2 の補数)。1 標本 = 1 ワード `{右 [31:16], 左 [15:0]}`
- **時間**: 標本化のクロックは映像と同じ PLL から作っているので、**映像の 1 フレームにちょうど 800 標本** (ずれていかない)。
  ホストは 1 フレームに 800 標本ずつ足せばよい
- **リング**: SDRAM のワードアドレス `PCM_BASE * 256` から `1 << PCM_SIZE` ワード。標本 k はリングの `k & (大きさ - 1)` 番目
- **数え方**: `PCM_WR` (ホストが書いた数) と `PCM_RD` (再生した数) は 16bit で回る。`PCM_WR - PCM_RD` (16bit の差) が残り。
  残りがあるあいだ、48kHz で 1 標本ずつ鳴らす。なくなったら無音を出し、`UNDERRUN` を 1 増やす
- **足し方**: 標本 `PCM_WR` からの n 個をリングの位置に `UPLOAD` し (リングの端で 2 つに分ける)、続けて `REG_WRITE PCM_WR` で `PCM_WR + n` にする。
  どちらも FIFO の順に実行されるので、`PCM_WR` はデータが SDRAM に入ってから進む。残りがリングの大きさを越えないようにする (`PCM_RD` を読んで決める)
- **始め方**: `AUDIO_CTRL = 2` (空にする)、`PCM_BASE` / `PCM_SIZE`、`PCM_WR = 0` → 数フレーム分を書いて `PCM_WR` を進める → `AUDIO_CTRL = 1`
- **止め方**: `AUDIO_CTRL = 0` (無音、アンプを切る。`PCM_RD` は止まる)
- **くり返し**: 短い音をループさせるなら、リングに 1 周分を書いて `PCM_WR` を `PCM_RD + 65535` のように大きく先にしておけば、リングを回り続ける
- **余裕の目安**: 先回りは「ホストが止まりうる最長時間 + 1 フレーム」。止まらないホスト (RP2350) なら 2048 標本のリングに 1,600 標本 (2 フレーム分)。
  ハーネスの macOS のホストは 45ms 止まることがあったので、8192 標本のリングに 6,000 標本 (125ms) で 10 分途切れなかった。
  1 フレーム分 (800 標本) は 3,200 バイトで、SPI 8MHz の 1 フレーム (約 16KiB) の 2 割
- **SDRAM**: 1 標本に 1 ワード読む (表示の次の優先度)。表示の締め切りにも描く速さにも効かない
- 例: [`harness.py audio`](../tools/harness/harness.py) (正弦波を流し続け、アンダーランと 48kHz を確かめる)

## 13. Mode 7 と霧

面 A を SNES の Mode 7 (BG1) と同じ計算で描く。回転・拡大・遠近 (道路) ができる。出力には行ごとの倍率と加算を掛けられる (霧・フェード)。
計算は SNES (bsnes) と同じ桁なので、SNES の Mode 7 のレジスタを写せば同じピクセルが出る。

### データ (VRAM)

| | 形式 | 大きさ |
| --- | --- | --- |
| マップ | 128 x 128 セル、1 セル 1 バイト (タイル番号 0..255)。セル n (= 行 x 128 + 列) はワード `M7_MAP_BASE + n / 4` のバイト `n % 4` (下位から) | 4,096 ワード (16KiB) |
| タイル | 256 個、8 x 8、8bpp。タイル t のピクセル (x, y) はワード `M7_PAT_BASE + t * 16 + y * 2 + x / 4` のバイト `x % 4` | 4,096 ワード (16KiB) |
| 行列の表 | 直接: ライン l は `M7_TBL_BASE + 2l` に `{B, A}`、`+ 2l + 1` に `{D, C}` (下位 16bit が先)。遠近: `M7_TBL_BASE + l` の `[15:0]` に z | 480 / 240 ワード |
| 霧の表 | ライン l は `LINE_FX_BASE + l` に `{LINE_ADD [31:16], LINE_MUL [14:0]}` | 240 ワード |

- ピクセルの値はパレットの番号 (0..255)。**0 は透明**
- SNES はマップとタイルを 1 ワードの下位・上位バイトに交互に置くが、VDP は分けて置く。SNES の VRAM の 1 バイトの書き込みは、
  そのバイトを含むワードの書き直しになる (ホストが写しを持つ)
- 合計で約 34KiB。VRAM (64KiB) の残りに面 B やスプライトのタイルを置く

### レジスタ (`REG_WRITE`)

| 番号 | 名前 | 幅 | 既定 | 内容 |
| --- | --- | --- | --- | --- |
| 32 | `M7_SEL` | 8 | 0 | **SNES の M7SEL と同じ桁**: bit0 横反転、bit1 縦反転、`[7:6]` マップの外 (0 / 1 折り返す、2 透明、3 タイル 0)。`[5:2]` は使わない |
| 33 | `M7_CTRL` | 4 | 0 | bit0: 面 A を Mode 7 にする、bit1: EXTBG、`[3:2]` 行列の出どころ (0 レジスタ、1 表 (直接)、2 表 (遠近)、3 予約) |
| 34〜37 | `M7_A` `M7_B` `M7_C` `M7_D` | 16 | `0x0100`, 0, 0, `0x0100` | 行列 (符号付き 8.8)。遠近のときは `M7_A` = cos θ、`M7_B` = sin θ (符号付き 1.14、16384 = 1) |
| 38 / 39 | `M7_X0` `M7_Y0` | 13 | 0 | 回転の中心 (符号付き、マップのピクセル座標) |
| 40 / 41 | `M7_HOFS` `M7_VOFS` | 13 | 0 | スクロール (符号付き) |
| 42 / 43 | `M7_MAP_BASE` `M7_PAT_BASE` | 14 | 0 | マップ・タイルの VRAM のワードアドレス |
| 44 | `M7_TBL_BASE` | 14 | 0 | 行列の表の VRAM のワードアドレス |
| 45 / 46 | `M7_SX` `M7_SY` | 10 / 9 | 0 | SNES の画面 (0, 0) を置く VDP の画面の位置 (符号付き)。SNES の 256 x 224 を 320 x 240 の (32, 8) に置くなら 32 / 8 |
| 47 | `LINE_MUL` | 15 | `0x4210` | 行の倍率: `[4:0]` R、`[9:5]` G、`[14:10]` B (16 = 1 倍、31 = 1.94 倍) |
| 48 | `LINE_ADD` | 16 | 0 | 行の加算 (RGB565、各色で足して最大値で切る) |
| 49 | `LINE_FX_CTRL` | 1 | 0 | bit0: `LINE_MUL` / `LINE_ADD` を霧の表から読む |
| 50 | `LINE_FX_BASE` | 14 | 0 | 霧の表の VRAM のワードアドレス |

どれもほかの合成のレジスタと同じく、ラインの合成を始めるときに取り込む (`WAIT_LINE` のあとに書けばそのラインから)。
表を使うときは、表の値がそのラインだけレジスタの値の代わりになる。

### 計算

ラインの先頭 (ライン l、13bit の値は符号付き):

```text
  clip(n) = n & 0x2000 ? (n | ~1023) : (n & 1023)
  h  = clip(M7_HOFS - M7_X0),  v = clip(M7_VOFS - M7_Y0)
  Y  = l - M7_SY                              縦反転なら 255 - Y
  ox = ((A*h) & ~63) + ((B*v) & ~63) + ((B*Y) & ~63) + (M7_X0 << 8)
  oy = ((C*h) & ~63) + ((D*v) & ~63) + ((D*Y) & ~63) + (M7_Y0 << 8)
  遠近 (M7_CTRL[3:2] = 2) なら先に: A = D = (z * cos) >> 14、B = (z * sin) >> 14、C = -B (下位 16bit を符号付きに)
```

画面の x = i (0..319) のピクセル:

```text
  X  = i - M7_SX                              横反転なら 255 - X
  px = (ox + A*X) >> 8,  py = (oy + C*X) >> 8     (算術シフト)
  外 = (px | py) & ~1023 が 0 でない            → M7_SEL[7:6]: 0 / 1 は折り返し (下の & 127)、2 は透明、3 はタイル 0
  タイル = マップ[(py >> 3 & 127) * 128 + (px >> 3 & 127)]
  値     = タイルのピクセル (px & 7, py & 7)
```

- 値が 0 なら透明。順位は面 A の低優先 (2)。**EXTBG** (`M7_CTRL` bit1) なら値の `[7]` が優先度 (1 なら順位 5)、色は `[6:0]` (0 なら透明)
- `LAYER_CTRL` bit2 (面 A) が 0 なら描かない。Mode 7 のあいだウィンドウは描かない
- SNES との違い: スプライトは低優先 (順位 3) でも Mode 7 より上 (SNES の Mode 7 ではスプライトの優先度 0 が BG1 の下)。EXTBG は面 A 1 枚の
  優先度ビットで、SNES のように BG1 と BG2 を同時には出せない。ダイレクトカラー・モザイクはない

### 行ごとの値

- **直接の表** (`M7_CTRL[3:2]` = 1): ラインごとの行列。SNES の HDMA で行列を変えるゲームは、HDMA の表を 1 回の `VRAM_WRITE` にする
- **遠近の表** (`M7_CTRL[3:2]` = 2): ラインごとの奥行き z (符号なし 8.8)。地平線 h、カメラの高さ H、拡大 k なら z(l) = k * H / (l - h)。
  カメラの高さと地平線が変わらなければ表は書き換えず、向きは `M7_A` / `M7_B` (cos / sin)、位置は `M7_X0` `M7_Y0` `M7_HOFS` `M7_VOFS` を
  フレームに 1 回書く (`e7_fps` は 1 フレーム 12 ワードで 60fps)
- 地平線より上は `WAIT_LINE` で `M7_CTRL` bit0 を切り替え、ビットマップや面 A (通常のタイル) か背景色にする
- 表の書き換えはすぐ効く (VRAM と同じ)。表示中に書き換えるとその行から変わるので、2 組置いて `WAIT_VBLANK` のあとに `M7_TBL_BASE` を切り替える
- 表を使わずに `WAIT_LINE n` + `REG_WRITE` x 4 を 1 行ずつ並べてもよいが、1 フレーム約 840〜1,200 ワードになり、
  ハーネス v1 (実測 約 180KB/s) では 21fps しか出ない (実測)。コマンド FIFO より多いので、フレームの先頭から流し続ける必要もある

### 霧 (行の倍率と加算)

出力の色 c (各色) を

```text
  out   = min(最大値, ((c * L_eff) >> 4) + ADD)
  L_eff = min(63, (L_cell * L_line) >> 4)       L_cell はライトマップのセル (無効なら 16)、L_line は LINE_MUL
```

にする (背景色にも掛かる)。既定 (`LINE_MUL` = 16 x 3、`LINE_ADD` = 0) なら元の色。

- **霧**: 行 l の割合 f (0..1、遠いほど大きい) に対して `LINE_MUL = 16 * (1 - f)`、`LINE_ADD = 霧の色 * f`。道路なら z の表と一緒に霧の表を 1 回書く
- **フェード・暗転**: 全行同じ `LINE_MUL` を 1 回書くだけ (ライトマップを書き換えなくてよい)。白へのフェードは `LINE_ADD`
- **夜の霧**: ライトマップ (ランプ) と霧が同時に効く
- 段階は `L_line` が 5bit なので 1/16 刻み。SNES の `COLDATA` の固定色の加算 (半透明なし) は `LINE_ADD` で近似できる (減算・半透明はない)
- 例: `scenarios/e7_mode7.json` (回転、マップの外、反転、EXTBG、SX / SY、遠近の道路 + 霧の表、直接の表 + ライトマップ + 霧)、
  `scenarios/e7_fps.json` (回る道路)

## 14. 3D GPU (別のビットストリーム)

`make bitstream TARGET=gpu3d` で作る 3D GPU のビットストリーム ([GPU3D_PLAN.md](GPU3D_PLAN.md)) の分。VDP の面・スプライト・8bpp の表示・ライトマップ・
Mode 7・音はなく、表示は RGB565 のビットマップ (背景色と透過色込み) だけ。2D のコマンドは RGB565 の `CLEAR` `FILL_RECT` `POINT` `DRAW_LINE` `UPLOAD`
と `REG_WRITE` 0〜2 などが使える (G3 から 8bpp で描くこと、`BLIT`、`BLIT4`、`STRETCH_BLIT` はない。エラーが立つ。画像はテクスチャの四角形で描く)。
`VERSION` (0x7F) は `0x81` (bit7 が 3D GPU の印)。0x50..0x5F は乗算器の確かめ (`harness.py mulprobe`)。
コマンド FIFO は **2,048 ワード** (VDP は 512。`GPU_FREE` で見る)。SDRAM の BIST (`MEM_CMD` 1) はなく、`MEM_STATUS` bit4 が 1
(1 ワードの読み書き `MEM_CMD` 2 / 3、取り込み位置、位相のレジスタはある)。

### コマンド

| 番号 | 名前 | ワード | 内容 |
| --- | --- | --- | --- |
| `0x20` | `TRI` | 4〜13 | 三角形。`[23:16]` フラグ (bit0 Gouraud、bit1 テクスチャ、bit2 半透明、bit3 Z、`[5:4]` 半透明の式)、`[15:0]` 単色 (RGB565、Gouraud でもテクスチャでもなければ)。続けて頂点ごとに `{y, x}` (符号付き 12.4 = 1/16 ピクセル)、Gouraud なら `{r, g, b}` (`[23:16]`, `[15:8]`, `[7:0]`)、Z なら `{z}` (`[15:0]`)、テクスチャなら `{v, u}` (`[31:16]`, `[15:0]`、10.6 = 1/64 テクセル) |
| `0x21` | `SET_TEX` | 2 | 今のテクスチャ。`[17:16]` 形式 (0 16bpp RGB565、1 8bpp、2 4bpp)、`[15:8]` CLUT のずらし、`[7:4]` 幅の log2、`[3:0]` 高さの log2 (8〜256)。2 ワード目 `[20:0]` 先頭のワードアドレス (**テクスチャのワード数の倍数**) |
| `0x28` | `CLUT_WRITE` | 1 + (n + 1) / 2 | CLUT (256 色、RGB565) の `[23:16]` 番から `[8:0]` 色 (n) を書く。1 ワードに 2 色 (下位が先) |
| `0x24` | `CLEAR_Z` | 1 | Z バッファ全体 (320 x 240 x 16bit) を `[15:0]` で塗る |

`REG_WRITE 27 Z_BASE` (13bit、256 ワード単位、既定 `0x0E00` = SDRAM の 0x380000 バイト): Z バッファの先頭。ピクセル (x, y) の z はワードアドレス
`(Z_BASE + y) * 256 + x / 2` の 16bit (下位が偶数の x。フレームバッファと同じ並び)。

### 規則 (同じ絵を出す規則)

正は [`tools/harness/raster.py`](../tools/harness/raster.py) (RTL と同じ整数の計算。CRC が一致する)。要点:

- 頂点は **-512..+831 ピクセル** (ガードバンド) の中。外にはみ出す三角形はホストがクリップする
- ピクセル (px, py) の中心 (px + 0.5, py + 0.5) が三角形の中なら描く。辺の上は **上左の規則** (上の辺と左の辺の上だけ中)。辺を共有する三角形に隙間も重なりもない。
  矩形を 2 つに割った三角形は `FILL_RECT` と同じピクセルを塗る
- どちらの向き (時計回り / 反時計回り) も描く。面積 0 は描かない。クリップ矩形 (`CLIP`) の外は描かない
- 属性 (r, g, b, z) は頂点の値の線形補間。固定小数点 12bit、勾配は面積の逆数 (17bit の仮数) から作るので、頂点の値と少しずれることがある (切り捨て)。
  値は 0..255 (色)、0..65535 (z) で切る。色は RGB565 に切り捨て
- Z (フラグ bit3): **z < Z バッファ** なら通り、色と z を書く。同じ z は先に描いたものが勝つ。Z なしの三角形は Z バッファを読まず書かない
- 描く面は `DRAW_BASE` の RGB565 (`BITMAP_FMT` によらない)
- テクスチャ (フラグ bit1、G3): u, v も属性として同じ式で補間し、テクセル (tu, tv) = (u >> 6, v >> 6) を幅・高さで折り返す (はみ出しは繰り返し)。
  テクスチャは SDRAM に **8 ワードのかたまり** の並び (キャッシュの 1 行。16bpp は 4 x 4 テクセルで 1 行 2 ワード、8bpp は 4 x 8、4bpp は 8 x 8 で 1 行 1 ワード)。
  かたまりは左上から行ごと、かたまりの中も行ごと (`raster.py` の `tex_index`)。1 ワードの中は 16bpp は 2 つ (下位が偶数の u)、8bpp は 4 つ (u % 4 番目のバイト)、
  4bpp は 8 つ (u % 8 番目が `[31 - 4k -: 4]`)。G5 のあとで横 1 行の並びから変えた (奥に向かう面でもキャッシュが当たる)。
  8 / 4bpp は `CLUT[(値 + ずらし) & 255]` の色。**色 0 (RGB565 の 0x0000) は透明** (色も Z も書かない)。Gouraud なら頂点の色で変調する (128 = 1 倍):
  R = min(31, texR * r >> 7) など。Gouraud でなければテクセルの色そのまま。遠近補正はない (画面で線形)
- 半透明 (フラグ bit2、G4): 描く色 F (テクスチャ・変調のあと) を描く面の色 B と RGB565 の成分ごとに混ぜる。式はフラグ `[5:4]`:
  0 平均 `(B + F) >> 1`、1 加算 `min(最大, B + F)`、2 減算 `max(0, B - F)`、3 1/4 加算 `min(最大, B + (F >> 2))`。
  Z があれば Z テストはするが、**Z は書かない**。透明のテクセル (色 0) は描かない。三角形は投入順に描くので、不透明を全部送ってから半透明を送る
  (半透明どうしは奥から手前に並べる)。シーンの外の `TRI` も描く面と混ざる
- `TRI` はそのときの `SET_TEX` を覚える (シーンの中で `SET_TEX` を変えてよい)。`CLUT_WRITE` はすぐ効くので、シーンの中では変えない (`END_SCENE` のときの CLUT で描く)

### シーン (TBDR、G2)

| 番号 | 名前 | ワード | 内容 |
| --- | --- | --- | --- |
| `0x25` | `BEGIN_SCENE` | 1 | シーンを始める。`[23:16]` フラグ: bit0 描く面を `[15:0]` の色で消す (でなければ今の面の上に描く)、bit1 Z を 0xFFFF から (でなければ Z バッファを読む)、bit2 最後の Z を Z バッファに書き戻す |
| `0x26` | `END_SCENE` | 1 | シーンの三角形をタイル (32 x 32、80 個) ごとに描いて、描く面 (と Z) に書く。終わるまで次のコマンドは待つ |

- シーンの中の `TRI` はその場では描かず、`END_SCENE` で投入順に描く。結果はシーンの外で同じ順に描いたものと同じピクセル (消すシーンなら `CLEAR` + `CLEAR_Z` のあと)
- 消すシーンは画面全体を消す (クリップ矩形によらない。`CLEAR` と同じ)。描く面は `END_SCENE` のときの `DRAW_BASE`
- シーンの中で `FILL_RECT` などの 2D のコマンドを使わない (三角形より先に描かれてタイルの書き出しで消える)。2D は `BEGIN_SCENE` の前か `END_SCENE` のあと
- 上限: 1 シーン **4,096 個**、1 タイル **1,024 個**。超えた三角形は (そのタイルで) 描かず、`GPU_STATUS` のエラーが立つ
- SDRAM: パラメータバッファ (バイト 0x080000〜0x0FFFFF) とタイルのリスト (0x100000〜0x14FFFF) を使う (アプリケーションのデータを置かない)
- シーンの外の `TRI` も内部では 1 つだけのシーンとして描く (外接矩形のタイルを読んで書き戻す)。たくさん描くならシーンにまとめる

### 速さ

シーン (TBDR): 1 フレーム (60Hz) に、画面全体の Gouraud + Z で約 5 画面分 (1 ピクセル約 1.1 クロック、Z と色はオンチップ)。小さい三角形は
1 個あたり ビニング約 200 クロック (セットアップ約 140 込み) + タイルごとに約 90 クロック + ピクセル。テクスチャはキャッシュ (64 行 x 8 ワード) が外れると
1 回約 17 クロック止まる (`g3_tex` でヒット率 96%)。半透明も 1 ピクセル約 1 クロック (不透明と同じ) で、Z で隠せないので重ねた枚数だけかかる
(画面全体のテクスチャの重ね描きは 60fps で約 4 枚)。シーンの外の `TRI` は、触れるタイルを読み書きするので遅い。ハーネス v1 の SPI (1 フレーム約 3KB) では `TRI` (Gouraud + Z で 10 ワード) は 1 フレーム約 75 個まで
