fpt/tang-verilog/harness/kicad/v2/rp-tang-harness-v2.kicad_pcb

## KiCad design harness/kicad/v2/rp-tang-harness-v2.kicad_pcb (2026-10-28)

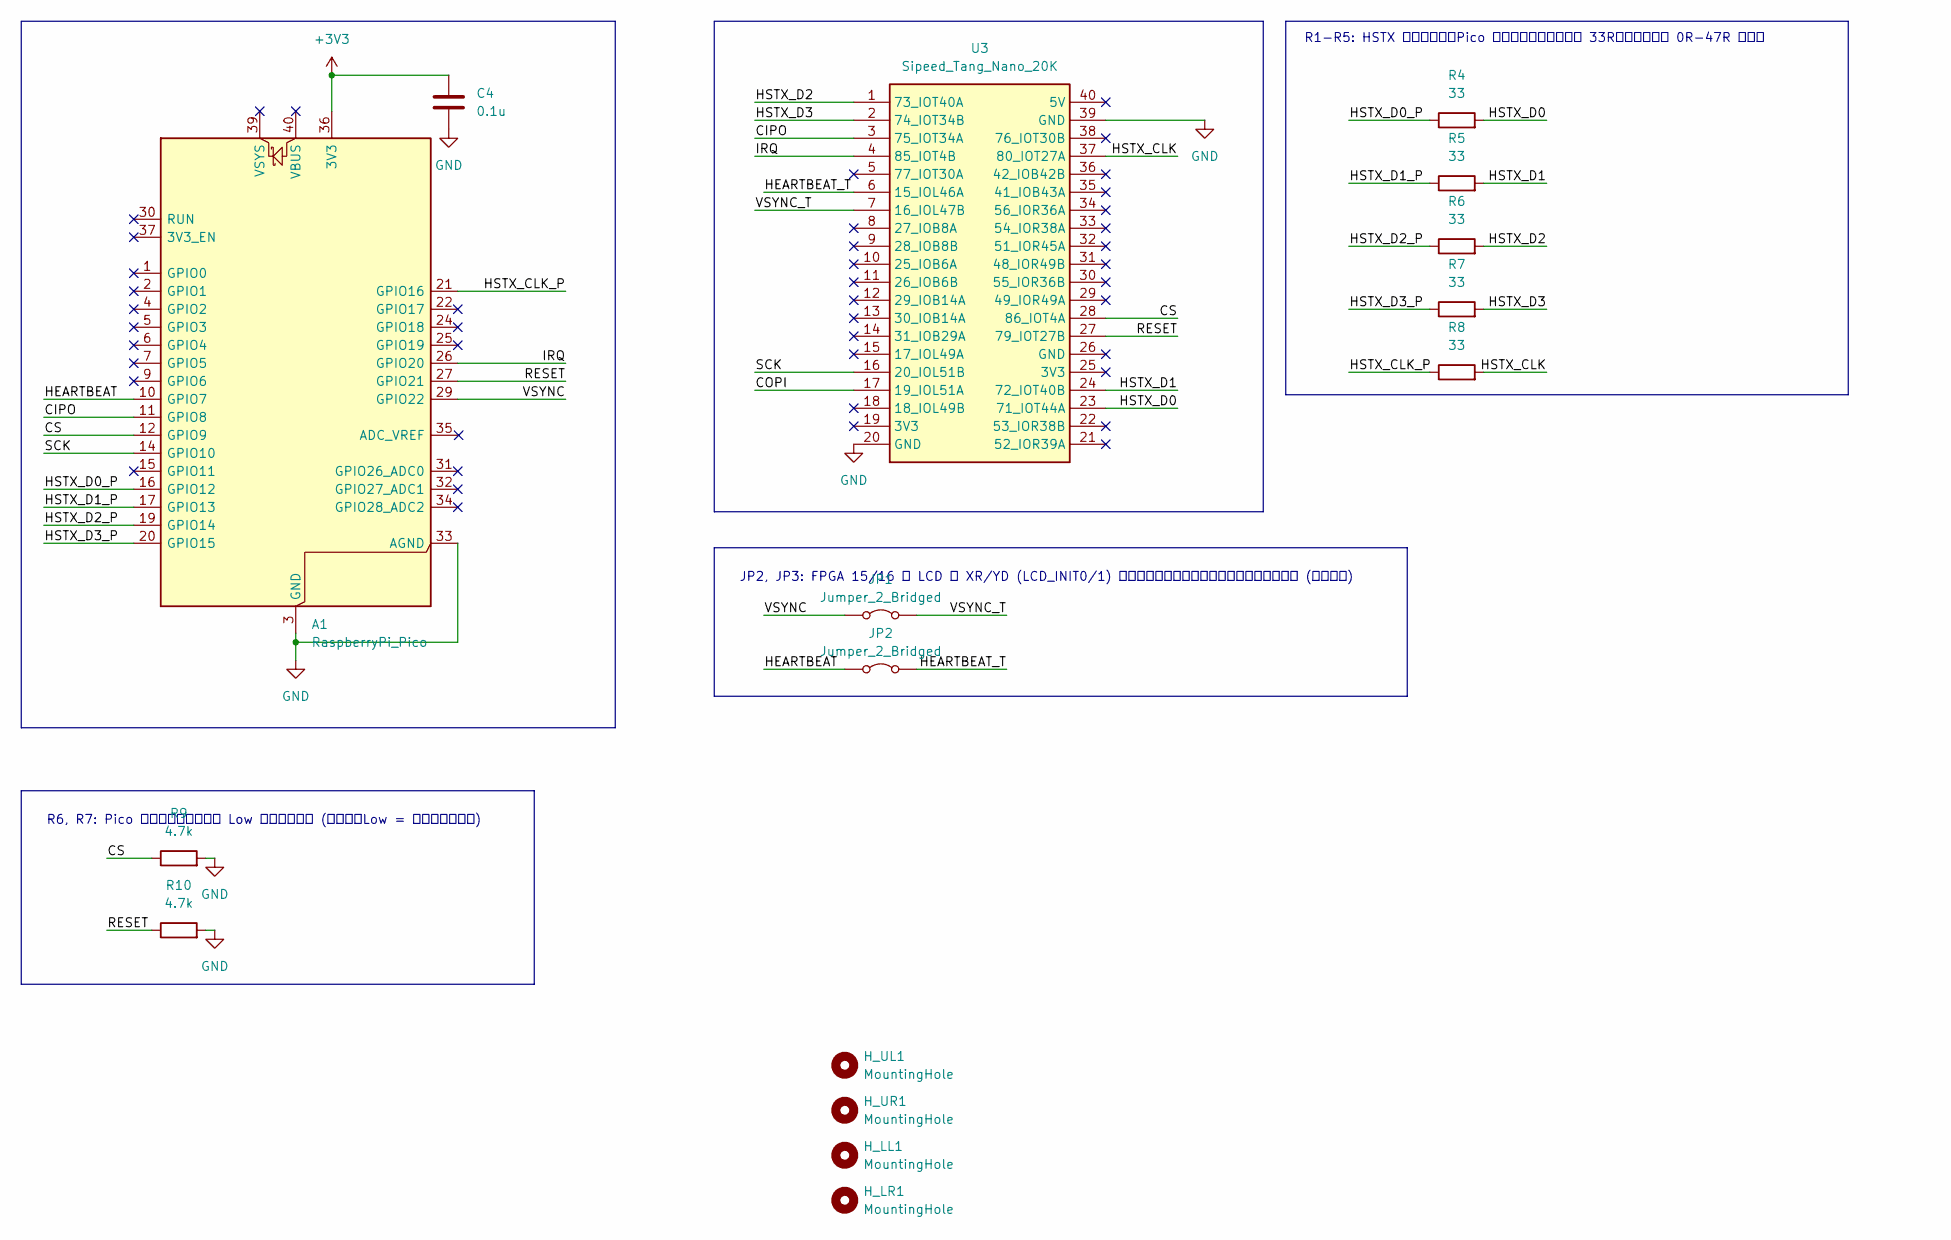
[picture p2: schematic rp-tang-harness-v2.kicad_sch]

Parts:
A1: RaspberryPi_Pico; RaspberryPi_Pico_Common_Unspecified
C4: 0.1u; C_Disc_D5.0mm_W2.5mm_P5.00mm
H_LL1: MountingHole; MountingHole_2.7mm
H_LR1: MountingHole; MountingHole_2.7mm
H_UL1: MountingHole; MountingHole_2.7mm
H_UR1: MountingHole; MountingHole_2.7mm
JP1, JP2: Jumper_2_Bridged; PinHeader_1x02_P2.54mm_Vertical
R4, R5, R6, R7, R8: 33; R_Axial_DIN0207_L6.3mm_D2.5mm_P7.62mm_Horizontal
R9, R10: 4.7k; R_Axial_DIN0207_L6.3mm_D2.5mm_P7.62mm_Horizontal
U3: Sipeed_Tang_Nano_20K; DIP-40_TangNano20K

Connections:
+3V3: A1.36 (3V3), C4.1
/CIPO: A1.11 (GPIO8), U3.3 (75_IOT34A)
/COPI: U3.17 (19_IOL51A)
/CS: A1.12 (GPIO9), R9.1, U3.28 (86_IOT4A)
/HEARTBEAT: A1.10 (GPIO7), JP2.1 (A)
/HEARTBEAT_T: JP2.2 (B), U3.6 (15_IOL46A)
/HSTX_CLK: R8.2, U3.37 (80_IOT27A)
/HSTX_CLK_P: A1.21 (GPIO16), R8.1
/HSTX_D0: R4.2, U3.23 (71_IOT44A)
/HSTX_D0_P: A1.16 (GPIO12), R4.1
/HSTX_D1: R5.2, U3.24 (72_IOT40B)
/HSTX_D1_P: A1.17 (GPIO13), R5.1
/HSTX_D2: R6.2, U3.1 (73_IOT40A)
/HSTX_D2_P: A1.19 (GPIO14), R6.1
/HSTX_D3: R7.2, U3.2 (74_IOT34B)
/HSTX_D3_P: A1.20 (GPIO15), R7.1
/IRQ: A1.26 (GPIO20), U3.4 (85_IOT4B)
/RESET: A1.27 (GPIO21), R10.1, U3.27 (79_IOT27B)
/SCK: A1.14 (GPIO10), U3.16 (20_IOL51B)
/VSYNC: A1.29 (GPIO22), JP1.1 (A)
/VSYNC_T: JP1.2 (B), U3.7 (16_IOL47B)
GND: A1.3 (GND), A1.8 (GND), A1.13 (GND), A1.18 (GND), A1.23 (GND), A1.28 (GND), A1.33 (AGND), A1.38 (GND), C4.2, R9.2, R10.2, U3.20 (GND), U3.39 (GND)

Notes on the sheet:
R1-R5: HSTX の直列抵抗。Pico の近くに置く。最初は 33R、波形を見て 0R-47R に調整
JP2, JP3: FPGA 15/16 は LCD の XR/YD (LCD_INIT0/1) と共有。それを使うパネルのときだけ開ける (既定は閉)
R6, R7: Pico が離しているあいだ Low に確定させる (正論理、Low = 何もしていない)

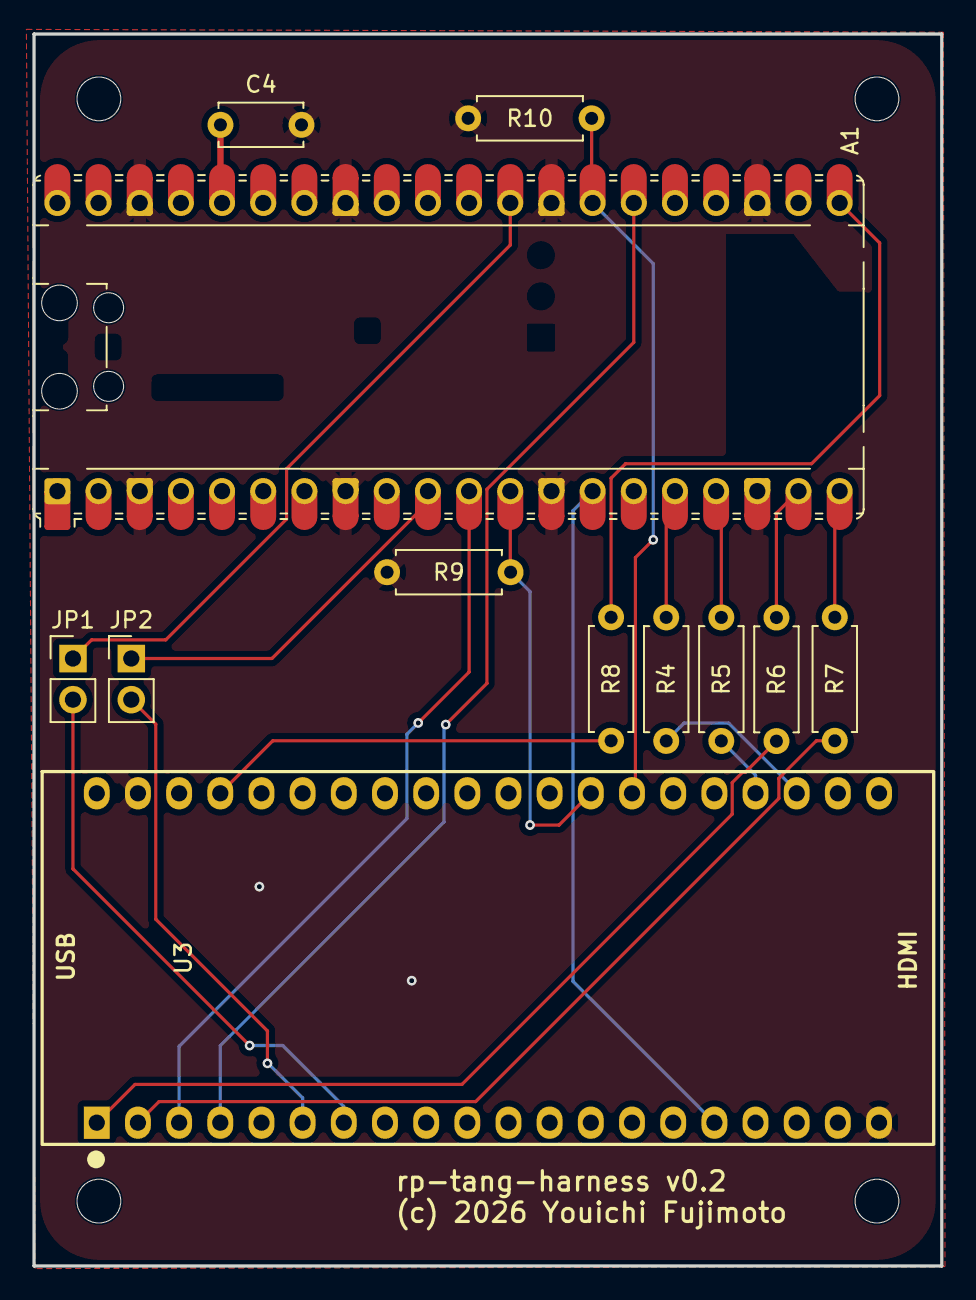
[picture p3: board rp-tang-harness-v2.kicad_pcb from above]

Board: 2 copper layers, 56.0 x 76.0 mm, 16 parts (0 on the bottom side), 21 nets.
