fpt/tang-verilog/harness/kicad/v1/rp-tang-harness.kicad_pcb

## KiCad design harness/kicad/v1/rp-tang-harness.kicad_pcb (2026-10-23, an earlier design)

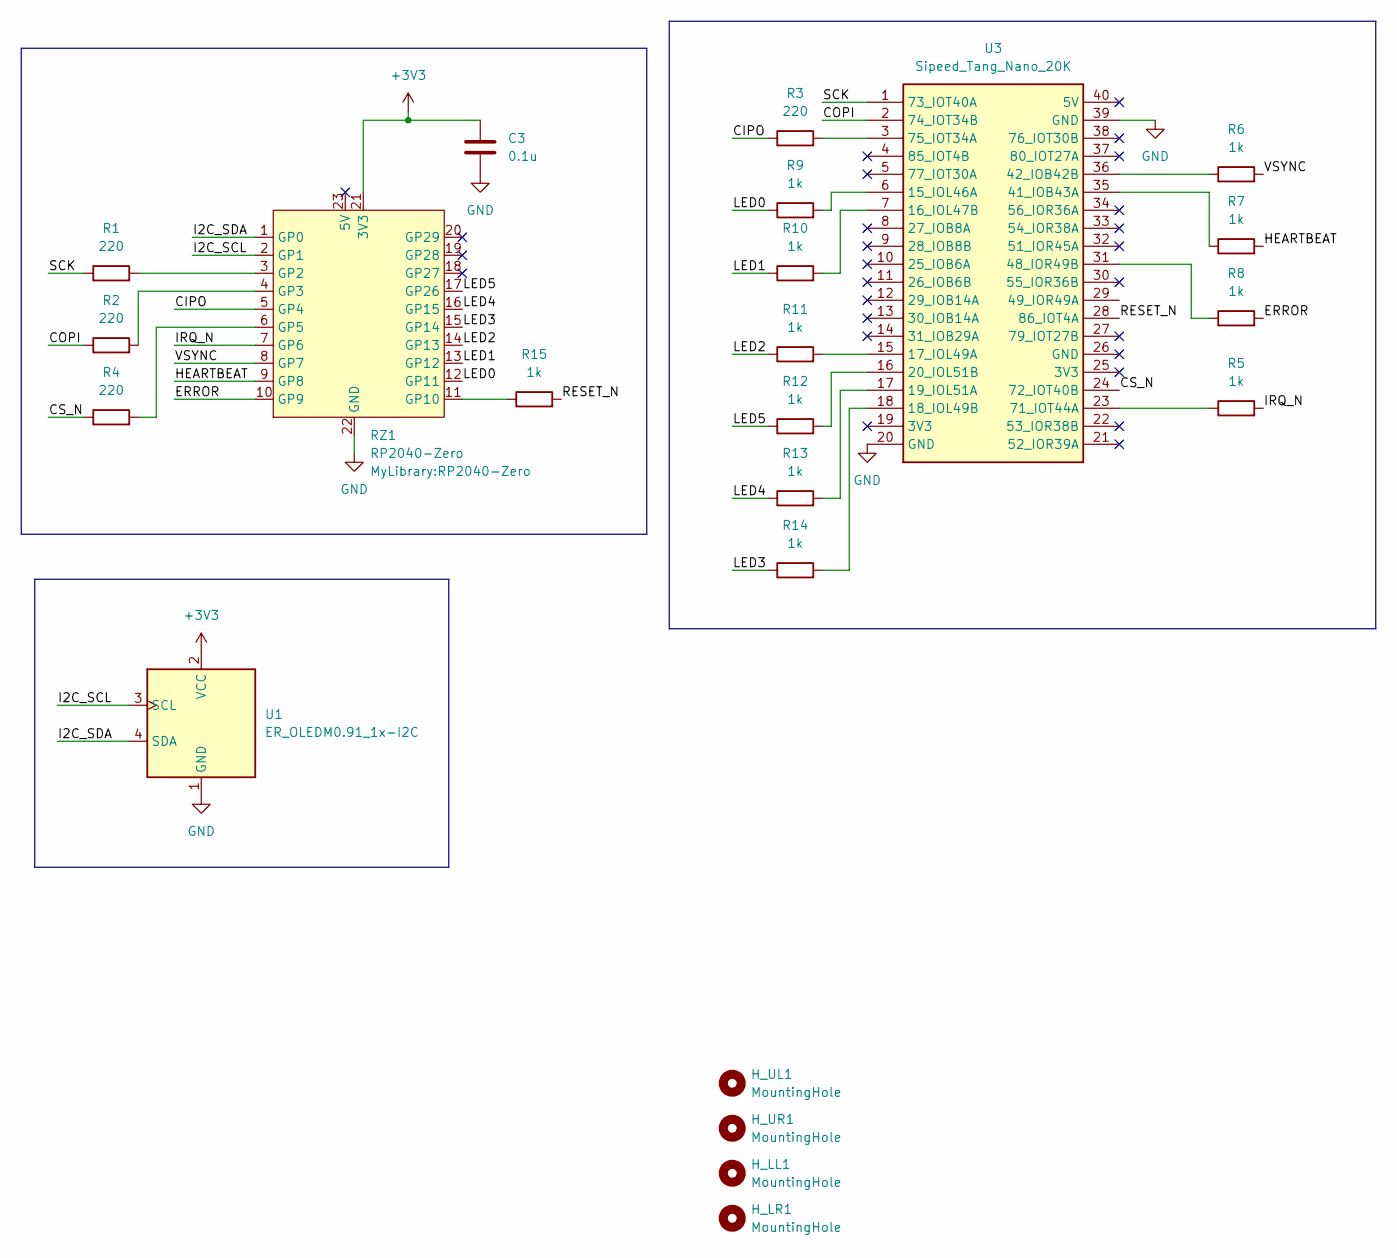
[picture p4: schematic rp-tang-harness.kicad_sch]

Parts:
C3: 0.1u; C_Disc_D5.0mm_W2.5mm_P5.00mm
H_LL1: MountingHole; MountingHole_2.7mm
H_LR1: MountingHole; MountingHole_2.7mm
H_UL1: MountingHole; MountingHole_2.7mm
H_UR1: MountingHole; MountingHole_2.7mm
R1, R2, R3, R4: 220; R_Axial_DIN0207_L6.3mm_D2.5mm_P7.62mm_Horizontal
R5, R6, R7, R8, R9, R10, R11, R12, R13, R14, R15: 1k; R_Axial_DIN0207_L6.3mm_D2.5mm_P7.62mm_Horizontal
RZ1: RP2040-Zero
U1: ER_OLEDM0.91_1x-I2C; SSD1306 OLED 096 I2C
U3: Sipeed_Tang_Nano_20K; DIP-40_TangNano20K

Connections:
+3V3: C3.1, RZ1.21 (3V3), U1.2 (VCC)
/CIPO: R3.1, RZ1.5 (GP4)
/COPI: R2.1, U3.2 (74_IOT34B)
/CS_N: R4.1, U3.24 (72_IOT40B)
/ERROR: R8.2, RZ1.10 (GP9)
/HEARTBEAT: R7.2, RZ1.9 (GP8)
/I2C_SCL: RZ1.2 (GP1), U1.3 (SCL)
/I2C_SDA: RZ1.1 (GP0), U1.4 (SDA)
/IRQ_N: R5.2, RZ1.7 (GP6)
/LED0: R9.1, RZ1.12 (GP11)
/LED1: R10.1, RZ1.13 (GP12)
/LED2: R11.1, RZ1.14 (GP13)
/LED3: R14.1, RZ1.15 (GP14)
/LED4: R13.1, RZ1.16 (GP15)
/LED5: R12.1, RZ1.17 (GP26)
/RESET_N: R15.2, U3.28 (86_IOT4A)
/SCK: R1.1, U3.1 (73_IOT40A)
/VSYNC: R6.2, RZ1.8 (GP7)
GND: C3.2, RZ1.22 (GND), U1.1 (GND), U3.20 (GND), U3.39 (GND)
unnamed: R1.2, RZ1.3 (GP2)
unnamed: R2.2, RZ1.4 (GP3)
unnamed: R4.2, RZ1.6 (GP5)
unnamed: R15.1, RZ1.11 (GP10)
unnamed: R9.2, U3.6 (15_IOL46A)
unnamed: R10.2, U3.7 (16_IOL47B)
unnamed: R11.2, U3.15 (17_IOL49A)
unnamed: R14.2, U3.18 (18_IOL49B)
unnamed: R13.2, U3.17 (19_IOL51A)
unnamed: R12.2, U3.16 (20_IOL51B)
unnamed: R7.1, U3.35 (41_IOB43A)
unnamed: R6.1, U3.36 (42_IOB42B)
unnamed: R8.1, U3.31 (48_IOR49B)
unnamed: R5.1, U3.23 (71_IOT44A)
unnamed: R3.2, U3.3 (75_IOT34A)

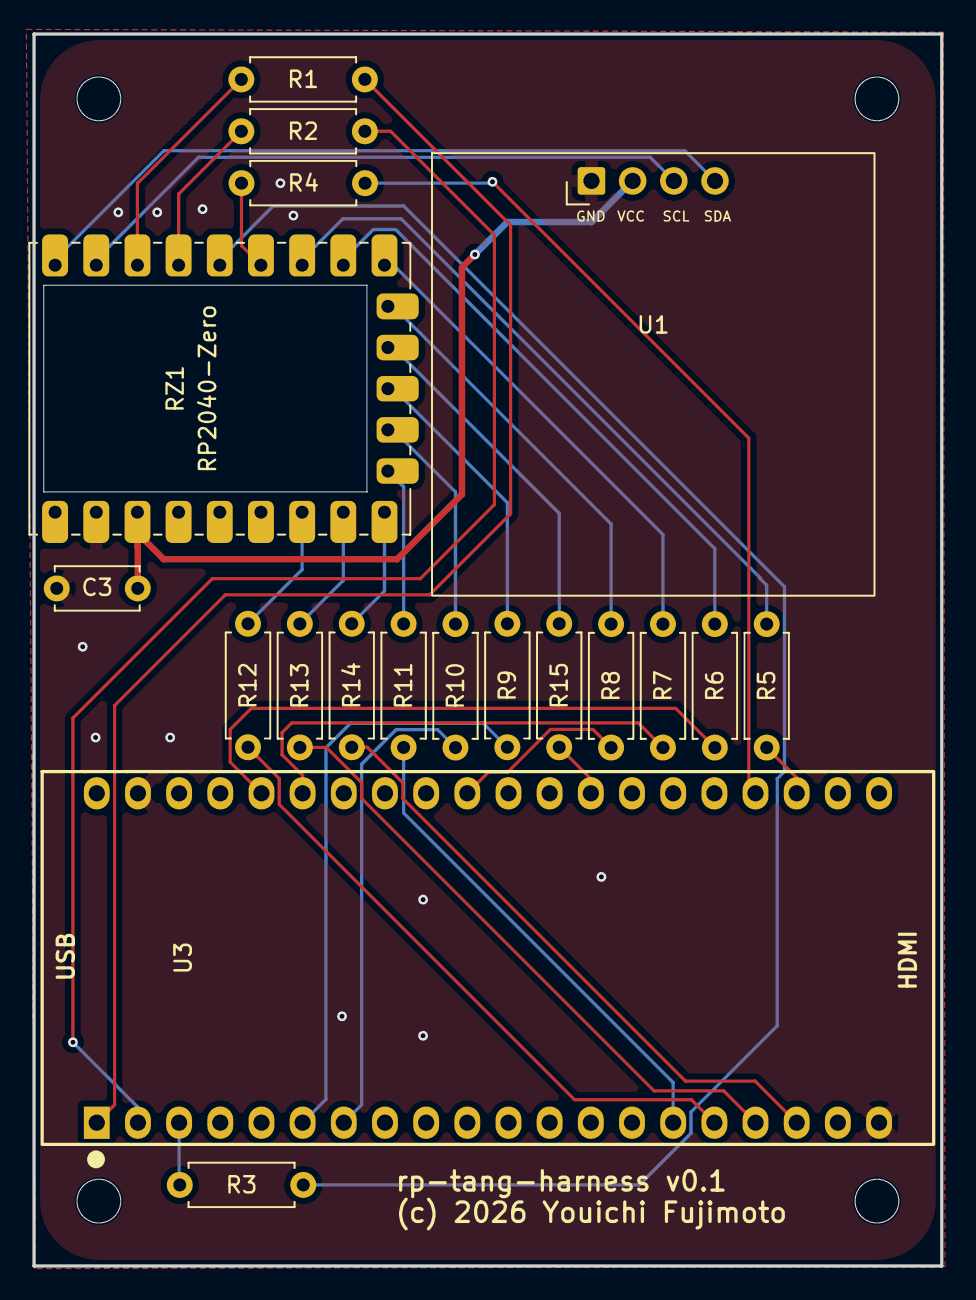
[picture p5: board rp-tang-harness.kicad_pcb from above]

Board: 2 copper layers, 56.0 x 76.0 mm, 23 parts (0 on the bottom side), 34 nets.
