fpt/tang-verilog/rtl/vdp/tile_layer.sv

// タイル レイヤ 1 面 (docs/EMU_GPU_PLAN.md の E2)。line_compositor が 1 ラインごとに start で動かす
//
//   VRAM とパレット: line_compositor が持ち、読み出しのポート (アドレスを出した次のクロックにデータ) をスプライトのパスと順番に使う
//   タイル:   8x8 ピクセル、4bpp。1 行が 1 ワードで、ピクセル i (左から) は [31-4i -: 4]。タイル t の行 r は pat_base + t*8 + r
//   マップ:   1 エントリ 16bit、1 ワードに 2 つ (下位が偶数の列。ctrl[7] = 1 なら上位が偶数の列 = メガドラの VRAM をビッグエンディアンの
//             32bit ワードで読んだ並び)。列 c、行 r のエントリは map_base + (r * 幅 + c) / 2。
//             [10:0] タイル番号、[11] 左右反転、[12] 上下反転、[14:13] パレット、[15] 優先度 (px_pri に出す)
//   色:       ピクセルの値 0 は透明 (下のレイヤが見える)。それ以外はパレットの {ctrl[6:4], エントリのパレット, 値}
//   ctrl:     [1:0] マップの幅 (0: 32, 1: 64, 2: 128 タイル)、[3:2] 高さ (0: 32, 1: 64, 2: 128, 3: 28 タイル = SMS)、
//             [6:4] パレットのバンク、[7] マップのエントリの並び (上を見よ)
//   スクロール: 画面のピクセル (x, line) は、マップのピクセル ((x + scroll_x) mod 幅, (line + scroll_y) mod 高さ)。
//             高さ 28 タイル (224 ピクセル) のときは scroll_y < 224 にする
//
//   動き方: start で、line の 1 ライン分 (SRC_W ピクセル) を x の順に 1 クロックに 1 つ出す。1 タイルごとに
//           マップを読む (1 クロック) -> タイルの行を読む (1 クロック) -> 8 ピクセルを 1 クロックに 1 つ、パレットを引いて出す。
//           1 ラインは約 (3 + 8) x 41 = 450 クロック。終わるまで busy
//   出力:   px_valid のクロックに、画面の x = px_x のピクセル {px_opaque, px_pri, px_color}。
//           その 1 クロック前に next_word = x / 2 を出す (受け側が作業ラインの今の値を先に読んでおけるように)
//
//   スクロールなどの入力は start から busy が落ちるまで変えないこと (line_compositor がラインの開始で取り込んだ値を渡す)。
module tile_layer #(
    parameter int SRC_W = 320
) (
    input  logic        clk,
    input  logic        rst,
    // VRAM とパレットの読み出し (1 クロック遅れ)
    output logic [13:0] vram_raddr,
    input  logic [31:0] vram_q,
    output logic [8:0]  pal_raddr,
    input  logic [15:0] pal_q,
    // 1 ラインの合成
    input  logic        start,
    input  logic [7:0]  line,
    input  logic [9:0]  scroll_x,
    input  logic [9:0]  scroll_y,
    input  logic [13:0] map_base,
    input  logic [13:0] pat_base,
    input  logic [7:0]  ctrl,
    output logic        busy,
    // ピクセルの出力
    output logic [7:0]  next_word,
    output logic        px_valid,
    output logic [8:0]  px_x,
    output logic        px_opaque,
    output logic        px_pri,
    output logic [15:0] px_color
);
    // 出力はパレットを引いた次のクロック
    logic        p_valid, p_opaque, p_pri;
    logic [8:0]  p_x;
    assign px_valid  = p_valid;
    assign px_x      = p_x;
    assign px_opaque = p_opaque;
    assign px_pri    = p_pri;
    assign px_color  = pal_q;

    // ================================================================ ラインの合成
    typedef enum logic [1:0] {T_IDLE, T_MAP, T_PAT, T_EMIT} tstate_t;
    tstate_t state;

    logic [8:0]  x;               // 書く画面の x
    logic [6:0]  col;             // マップの列
    logic [2:0]  px;              // タイルの中の x (反転の前)
    logic [6:0]  row;             // マップの行
    logic [2:0]  fine_y;
    logic [31:0] pat;             // タイルの今の行
    logic        hflip;
    logic [1:0]  pal_sel;
    logic        pri;
    logic        col_odd;         // 読んだマップのワードのどちらのエントリか
    logic        first;           // T_MAP の 1 クロック目

    // マップの大きさ
    logic [6:0] col_mask;
    always_comb begin
        unique case (ctrl[1:0])
            2'd0:    col_mask = 7'd31;
            2'd1:    col_mask = 7'd63;
            default: col_mask = 7'd127;
        endcase
    end

    // スクロールしたマップの y: 2 のべきの高さはマスク、28 タイルは 224 を最大 2 回引く (line + scroll_y < 240 + 224)
    logic [10:0] vy_sum, vy;
    always_comb begin
        vy_sum = 11'(line) + 11'(scroll_y);
        unique case (ctrl[3:2])
            2'd0: vy = vy_sum & 11'd255;
            2'd1: vy = vy_sum & 11'd511;
            2'd2: vy = vy_sum & 11'd1023;
            default: begin
                vy = vy_sum;
                if (vy >= 11'd224) vy = vy - 11'd224;
                if (vy >= 11'd224) vy = vy - 11'd224;
            end
        endcase
    end

    // マップのエントリの番号 (行 x 幅 + 列) とワードアドレス
    logic [13:0] map_index;
    always_comb begin
        unique case (ctrl[1:0])
            2'd0:    map_index = {2'b0, row, 5'b0} + 14'(col);
            2'd1:    map_index = {1'b0, row, 6'b0} + 14'(col);
            default: map_index = {row, 7'b0} + 14'(col);
        endcase
    end

    logic [15:0] entry;
    assign entry = (col_odd ^ ctrl[7]) ? vram_q[31:16] : vram_q[15:0];

    logic [2:0] pi;               // 反転したあとのタイルの中の x
    logic [3:0] nib;
    assign pi  = hflip ? ~px : px;
    assign nib = pat[5'd28 - {pi, 2'b0} +: 4];

    always_comb begin
        vram_raddr = map_base + 14'(map_index >> 1);
        if (state == T_MAP && !first)   // マップのエントリが届いたクロック: タイルの行を読む
            vram_raddr = pat_base + {entry[10:0], entry[12] ? ~fine_y : fine_y};
        pal_raddr = {ctrl[6:4], pal_sel, nib};
    end

    assign busy   = state != T_IDLE || p_valid;
    assign next_word = x[8:1];

    // T_IDLE --start--> (マップを読む) T_MAP -> (タイルの行を読む) T_PAT -> T_EMIT x 8 -> T_MAP ...
    // T_MAP は 2 クロック: 1 クロック目 (first) にマップのアドレスを出し、2 クロック目に届いたエントリからタイルの行のアドレスを出す
    always_ff @(posedge clk) begin
        if (rst) begin
            state   <= T_IDLE;
            p_valid <= 1'b0;
            first   <= 1'b0;
        end else begin
            p_valid <= 1'b0;
            unique case (state)
                T_IDLE: if (start) begin
                    row    <= 7'(vy >> 3);
                    fine_y <= vy[2:0];
                    col    <= 7'(scroll_x >> 3) & col_mask;
                    px     <= scroll_x[2:0];
                    x      <= '0;
                    first  <= 1'b1;
                    state  <= T_MAP;
                end
                T_MAP: begin
                    if (first) begin
                        first   <= 1'b0;
                        col_odd <= col[0];
                    end else begin
                        hflip   <= entry[11];
                        pal_sel <= entry[14:13];
                        pri     <= entry[15];
                        state   <= T_PAT;
                    end
                end
                T_PAT: begin
                    pat   <= vram_q;
                    state <= T_EMIT;
                end
                T_EMIT: begin
                    p_valid  <= 1'b1;
                    p_opaque <= nib != 4'd0;
                    p_pri    <= pri;
                    p_x      <= x;
                    x        <= x + 9'd1;
                    px       <= px + 3'd1;
                    if (x == 9'(SRC_W - 1)) begin
                        state <= T_IDLE;
                    end else if (px == 3'd7) begin
                        col   <= (col + 7'd1) & col_mask;
                        first <= 1'b1;
                        state <= T_MAP;
                    end
                end
                default: state <= T_IDLE;
            endcase
        end
    end
endmodule
