fpt/tang-verilog/(commit log)

2026-10-14 use pico 2 for harness
2026-10-21 Add 800x480 RGB LCD target
    Output the same test pattern as the HDMI example on the 40-pin RGB LCD.
    - vdp_video: MODE parameter (0: 640x480 HDMI, 1: 800x480 LCD); vdp_core sizes bars/checker from the screen size
    - top_lcd: rPLL 27MHz -> 33MHz, RGB565 output, backlight on (timing from sipeed/TangNano-20K-example cross_bar)
    - Makefile: TARGET=hdmi|lcd selects top/cst/render mode; per-top logs; lint both modes
    - render: derive image size from DE instead of assuming 640x480
2026-10-22 Add harness wiring test and pin-direction check
    - harness/pins.json: single pin table for the RP2 <-> Tang Nano harness
    - scripts/pincheck.py: refuse to program a design that drives an RP2-driven pin; make prog/flash run it first
    - top_harness_probe (TARGET=harness_probe): FPGA outputs toggle at distinct rates, RP2-driven lines are echoed back
    - harness/firmware: RP2 test firmware (default RP2040-Zero); pins released to input+pull-down before/after every run,
    lines driven only after the passive phase passes; pins.h generated from pins.json
    - docs/HARNESS.md: wiring test section, pins.json instead of the YAML draft
2026-10-22 Add GPU plan and M0: RP2 bridge firmware and host tool
    - docs/GPU_PLAN.md: tiny-GPU plan (SDRAM framebuffer) verified with the harness
    - harness/firmware: bridge replacing the probe firmware (ping/status/spi/freq/reset/irqwait/wiretest/bootsel);
    SPI is driven only while HEARTBEAT toggles, pins return to input+pull-down after every transaction
    - tools/harness/harness.py: stdlib-only host tool, one JSON result per call; prog runs make prog (pincheck)
    - CS/RESET/IRQ are now active-high so released (pulled-down) lines mean idle
2026-10-22 Add M1: SPI slave and registers in the HDMI design
    - rtl/vdp/spi_slave.sv: mode 0 SPI slave sampled at 63MHz; 0xA5 sync byte, auto-increment, frame error
    - rtl/vdp/vdp_regs.sv: STATUS / CONTROL / FRAME_COUNT / SCRATCH / ID / VERSION, IRQ = VBLANK & IRQ_EN
    - top.sv: 63MHz clk_sys from rPLL CLKOUTD, harness pins (HEARTBEAT, VSYNC, IRQ, ERROR, RESET)
    - tb_spi_slave / tb_vdp_regs (Icarus + Verilator), lint for the new modules
    - harness.py: reg read/write and selftest
2026-10-22 Add M3: in-package SDRAM controller and BIST
    - constraints: 55 SDRAM signals at their internal IO locations (apicula doc/sdram.md); works with nextpnr-himbaechel + gowin_pack
    - rtl/vdp/sdram_ctrl.sv: 63MHz, CL2, single-word access with auto-precharge, refresh, runtime read sample point
    - rtl/vdp/mem_test.sv: BIST (per-address pattern + inverse) and single-word access via registers 0x10-0x2F
    - sim/sdram_model.sv + tb_sdram_ctrl / tb_mem_test; ODDR for the inverted SDRAM clock
    - harness.py: memtest and mem read/write
    - docs: ARCHITECTURE.md rewritten for the SDRAM framebuffer design, M3 results in GPU_PLAN.md
2026-10-22 Add M2: frame CRC and HDMI capture comparison
    - rtl/vdp/frame_crc.sv: CRC-32 of each frame's RGB pixels (same as zlib.crc32), FRAME_CRC at 0x05-0x08 with snapshot
    - CONTROL bit1 freezes the sprite so every frame is identical
    - make render FREEZE=1: reference frames + frames.json with CRCs computed in Python
    - tools/harness/imgcmp.py: capture by device name, colour-corrected comparison with edge allowance, diff image
    - harness.py frametest: CRC + capture check against the reference
2026-10-22 Add M4: SDRAM framebuffer display
    - fb_scanout: fetch line n+1 in a 160-word burst while line n is shown; 2-line BSRAM buffer; 320x240 RGB565 doubled to 640x480
    - sdram_arb: display reads have priority over memory test / upload
    - sdram_ctrl: burst reads (READ every cycle in a row, auto-precharge on the last)
    - mem_test: upload port at 0x30 (spi_slave does not advance 0x30-0x3F); BIST now reads in 256-word bursts
    - SDRAM read sample point default 5: only 5 is correct for bursts (6/7 passed single reads only via bus retention)
    - vdp_regs: UNDERFLOW (0x09), FB_BASE (0x0A-0x0B), CONTROL bit3
    - harness: fbmodel.py reference model + test image; fb upload/show/off, fbtest; memtest restores MEM_CFG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
2026-10-23 Add runtime SDRAM clock phase adjustment and revised M5 plan
    - second rPLL: clk_sys (63MHz) + CLKOUTP (phase-shifted 63MHz) -> ODDR -> SDRAM clock
    - MEM_CLK (0x15): PSDA phase in 1/16-cycle (~1ns) steps at runtime; DUTYDA = PSDA + 8 because DUTYDA is the
    absolute falling-edge position (fixed DUTYDA only moved the rising edge and collapsed the clock at 8-9)
    - harness memtest --phases: phase x sample-point BIST map; selftest records the phase margin (fails below 2 steps)
    - measured: rd_sample 5 passes at phases 12..3, default (phase 0, sample 5) has ~4ns / ~3ns margin
    - GPU_PLAN.md: M5 scope from pre_M5_review.md and the sweep result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
2026-10-23 Add M5: command GPU (CLEAR / FILL_RECT / SWAP / UPLOAD)
    - rtl/vdp/gpu.sv: 512-word command FIFO (BSRAM) fed via 0x30, GPU_STATUS / GPU_FREE / FB_BASE / DRAW_BASE;
    CLEAR, FILL_RECT (odd edges via DQM byte masks, clipping), SWAP (waits for scanout latch), UPLOAD
    - sdram_ctrl: write bursts (<= 64 words per GPU burst) with per-word byte mask (DQM), combinational wnext
    - sdram_arb: 3 clients (display > GPU > memory test)
    - fb_scanout: FB_BASE latched once per frame at line-0 prefetch, base_latched to GPU
    - frame_crc / vdp_regs: frame number with the CRC snapshot (CRC_FRAME 0x0A); FB_BASE moved to gpu (0x44)
    - mem_test: upload port removed (replaced by UPLOAD)
    - three-way check: tools/harness/gp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
2026-10-23 Bridge v2: bulk USB input and raw-byte spib writes
    - harness/firmware: read USB input in chunks (stdio_get_until into an input buffer) instead of getchar per byte;
    CDC RX/TX buffers 64 -> 1024 bytes; new `spib <n>` (n raw bytes after the line, reply = first rx byte only)
    - harness.py: use spib for writes when the bridge reports version >= 2, keep spi for v1
    - 2KiB write 62ms -> 9.6ms; 320x240 upload 4.8s -> 0.9s
2026-10-23 Add M6: DRAW_LINE, POINT and CLIP
    - gpu.sv: POINT (0x05), DRAW_LINE (0x06, integer Bresenham, signed 16-bit endpoints, off-screen allowed,
    one masked single-word write per in-clip pixel), CLIP (0x07, inclusive, clamped; applies to FILL_RECT /
    POINT / DRAW_LINE, not CLEAR); unified argument fetch (head word + 0..2 words)
    - gpu_model.py: same Bresenham and clip rules; scenario ops point / line / clip
    - tb_gpu: 320x16 screen, every pixel vs a testbench Bresenham (8 octants, axis, single point, off-screen,
    clip, empty clip, CLEAR ignores clip); cmd() now waits for GPU_FREE like the host; watchdog
    - scenarios/m6_lines.json: model = Verilator = hardware at all 3 checks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
2026-10-23 Add E1: line compositor, per-line registers, WAIT_LINE / WAIT_VBLANK, READY
    - rtl/vdp/line_compositor.sv replaces fb_scanout: per logical line, latch layer registers and compose the
    bitmap layer (SDRAM row, key pixels -> backdrop) or the backdrop into the line buffer; emits line_start /
    line_num; always runs (CONTROL bit3 only selects the output)
    - gpu.sv: BG_COLOR / LAYER_CTRL / BITMAP_KEY (0x48-0x4D), REG_WRITE (0x09), WAIT_LINE (0x0A),
    WAIT_VBLANK (0x0B, bit0 marks the next frame), ready output
    - frame_crc / vdp_regs: CRC of the marked frame held in MARK_CRC (0x0C) with MARK_COUNT (0x02);
    fix frame-start handling being part of the pixel if-else chain
    - top: IRQ pin = READY when CO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
2026-10-23 Add E2.5: rank-tagged working line
    - 合成器のレイヤごとのラインバッファ (tile_layer の tbuf) をやめ、各ピクセルに {順位 3bit, 色 16bit} を持つ作業ラインを 1 本にした
    - 各パスは「不透明で、格納済みより順位が高いときだけ書く」(1 クロック先行して読む 読み-比較-書き)
    - 順位: 0 背景色, 1 B 低, 2 A 低, 3 スプライト低, 4 B 高, 5 A 高, 6 スプライト高
    - 今のタイル レイヤは A 面 (マップの優先度ビットで 2 / 5)
    - REG_WRITE 8 = BITMAP_RANK (既定 1 = E2 と同じ重なり、0 で非表示)
    - シナリオ e2_ranks (透過色付きビットマップをタイルの低優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
2026-10-23 Add E3: sprites (OAM 128, per-line pixel limit)
    - sprite_layer.sv: OAM 128 エントリ (BSRAM 1 個)。1〜4 x 1〜4 タイル、反転、セルの並び順 (列優先 / 16 タイル幅の表)、
    パレット、優先度、符号付きの x / y。OAM を 1 クロックに 1 エントリ調べ、当たったらその場で描く
    - 1 ラインの上限はピクセル数 (SPR_LINE_PX、タイルの列で数え、画面の外の列も数える)
    - line_compositor: スプライトのパスを最初に走らせ、空いているところだけ書く (OAM の前が勝つ、順位 3 / 6)。
    VRAM とパレットを持ち、読み出しのポートをスプライトとタイルのパスで順番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
2026-10-23 Add M9: host-driven demo at 60fps, flash
    - tools/harness/demo.py: タイル レイヤの多重スクロール・空のグラデーション・水面の揺れ (WAIT_LINE)、
    スプライト 42 個 (OAM_WRITE)、図形 (ビットマップ 2 面に DRAW_LINE / FILL_RECT して SWAP) を毎フレーム作る。
    フレーム k のコマンドは k だけで決まる
    - harness.py demo / make demo: 実機で流し続け、fps・表示フレーム / 描画フレーム・UNDERFLOW を出す
    - シナリオ m9_demo (demo_setup / demo_frame): 印を付けたフレームをモデル・Verilator・実機で比べる
    - 文書: GPU_PLAN の M9 の結果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
2026-10-23 Add E4: plane B, window, H-scroll table, MD translation draft
    - line_compositor: 1 つの tile_layer を 面 B → 面 A → ウィンドウ の順に動かす。面 B の順位 1 / 4、
    ウィンドウはメガドラと同じ範囲の決め方 (WIN_H / WIN_V) で面 A を置き換える。
    横スクロールの表 (画面全体 / 8 ラインごと / ラインごと) をラインの先頭で VRAM から読む
    - tile_layer: TILE_CTRL[7] でマップのエントリの並びをメガドラ (ビッグエンディアン) にする
    - GPU: REG_WRITE 12〜21、LAYER_CTRL bit4、TILE_CTRL 8bit
    - tools/harness/md.py: メガドラの VDP の状態をコマンドに直す下書きと、メガドラ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
2026-10-24 Fix HARNESS2 and update KESSEL_ON_VDP after review
    - HARNESS2: fix schematic/pin table links, LCD_INIT pins (15-18, harness
    uses 15/16), ribbon neighbour wires, IRQ/READY high while unconfigured
    - pins_v2.json: fpga_lcd_init = [15, 16, 17, 18]
    - KESSEL_ON_VDP: sprite palette reach (per-sprite 4-bit bank), index-0
    transparency rule, clip rectangle, bitmap_rank = 6, map() vs plane
    wrap, cell order 2 bit placement
    - Remove the superseded Pico LiPo 2 schematic
2026-10-24 Add docs/SPECIFICATION.md for application developers
    Reference for hosts such as rs-kessel: SPI link and side wires, register
    map, every command with its word layout, REG_WRITE registers, data formats
    (framebuffer, palette, tiles, map entries, plane control, OAM),
    compositing ranks, timings, limitations, a frame recipe and how to verify
    against the reference model.
2026-10-24 Add K3: STRETCH_BLIT (nearest-neighbour scaling blit)
    - gpu: opcode 0x0E with src, {dh, dw}, {y, x}, {sw, stride}, sx_step,
    sy_step (16.16). Destination pixel (i, j) samples source
    ((step >> 1) + i * step) >> 16. Flags, transparency, clipping and
    565 / 8bpp / 4bpp sources as in BLIT; dw, dh up to 1024
    - Per destination row: reload the source row only when it changes, build
    destination words at one pixel per clock into a row buffer with
    per-byte transparency flags, then burst-write with byte masks
    - Model, tb_gpu checks (all formats, alignments, flips, clipping, limit
    error), scenarios k3_stretch and k3_fps (1.7 ms per full-screen 2x)
    - scripts/fix_netlist.py: bypass leftover $buf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
2026-10-24 Add K4: lightmap (per-cell RGB multiply at compositor output)
    - line_compositor: 40 x 30 cells (8 x 8 px) of 6-bit R/G/B factors
    (16 = 1x) in 2 BSRAMs; with LAYER_CTRL bit5 the output stage multiplies
    every composited pixel, background included: min(max, (c * L) >> 4).
    Read alongside the working line, so line timing is unchanged
    - gpu: LIGHT_WRITE (0x10) writes cells cy * 40 + cx, one per word
    ([5:0] R, [13:8] G, [21:16] B), wrapping at 2048; LAYER_CTRL is 6 bits
    - Model, tb_line_compositor lighting modes, tb_gpu LIGHT_WRITE check,
    scenario k4_light
    - Docs: SPECIFICATION, KESSEL_ON_VDP, ARCHITECTURE, README
2026-10-24 Add K5a: I2S audio from an SDRAM PCM ring
    - audio_out: 48 kHz stereo 16-bit I2S to the onboard MAX98357A (PA_EN 51,
    DIN 54, WS 55, BCK 56). BCLK 1.536 MHz from clk_sys with a +128 mod 2625
    accumulator, so exactly 800 samples per 60 Hz video frame
    - PCM lives in a power-of-two ring in SDRAM; the player prefetches one
    word per sample through a new arbiter port ranked just below display
    (display > audio > GPU > memtest). No extra BSRAM (44 / 46)
    - GPU REG_WRITE 23-26: AUDIO_CTRL, PCM_BASE, PCM_SIZE, PCM_WR (in FIFO order
    after UPLOAD). PCM_RD and UNDERRUN readable at 0x50-0x52
    - Pins 54-56 are SSPI dual-purpose: pass sspi_as_gpio to nextpnr and
    gowin_pack
    - Fix a torn multi-byte rea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
2026-10-24 Plan E7: Mode 7 layer with per-line VRAM tables, and fog
    Folds the Mode 7 / fog plan into EMU_GPU_PLAN.md with the review changes:
    M7_SEL in SNES M7SEL layout, bsnes-exact clip and & ~63, M7_SX/SY for
    320x240 vs 256x224, per-line matrix / perspective / fog tables in VRAM
    (no mid-frame command streaming, fits harness v1), serial shift-add
    multiplier, fog multiplier in the output stage instead of a table,
    window disabled in Mode 7. Old E7 remainder becomes E8.
2026-10-24 Add E7: Mode 7 layer (affine plane A) and per-line fog
    - mode7_layer.sv: SNES/bsnes-exact Mode 7 (clip, & ~63, M7SEL layout,
    SX/SY offset, EXTBG, outside-map modes), serial shift-add multiplier
    for the line-start setup (runs alongside the sprite/B passes), 2 clocks
    per pixel. Replaces plane A's tile pass; window is off in Mode 7.
    - Per-line tables read from VRAM at line start: direct matrix,
    perspective depth (A..D from z and cos/sin), and fog {ADD, MUL}.
    - Fog: output stage gets L_eff = min(63, L_cell * L_line >> 4) and a
    saturating per-line RGB565 add; defaults leave output unchanged.
    - REG_WRITE 32..50 go from gpu to line_compositor over an xreg bus.
    - Model, tb_mode7_layer, fog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
2026-10-25 Add G0: gpu3d bitstream skeleton and DSP check; fold review into GPU3D_PLAN
    - top.sv parameter GPU3D (make TARGET=gpu3d -> build/gpu3d/): fb_line
    (bitmap-only scanout with the compositor's line/WAIT_LINE/SWAP/mark
    semantics) replaces line_compositor, no audio, VERSION 0x81.
    - 2D scenarios match the VDP bitstream on model, Verilator
    (make scenario TARGET=gpu3d) and hardware.
    - mul_probe + harness.py mulprobe: signed MULT18X18 from the open
    toolchain computes unsigned on hardware (ASIGN/BSIGN ineffective);
    unsigned DSP multiply plus sign correction is correct. Rule added to
    CLAUDE.md.
    - GPU3D_PLAN: speed model, random-access and SPI costs, tile-corner
    stepping, normalised 1/area,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
2026-10-25 Add G2: tile-based deferred rendering (BEGIN_SCENE / END_SCENE)
    - tri_engine is now the binner: setup -> 24-word record in the
    parameter buffer, triangle index appended to each touched 32x32 tile
    list (on-chip counts; 4,096 per scene, 1,024 per tile, overflow sets
    the GPU error bit).
    - tile_engine: per tile, clear or load on-chip colour/Z, draw the
    tile's triangles in submission order (tile-corner values via 14
    multiplies, 1 px/clk with on-chip Z), write out; buffers are reset to
    the clear value as they are written out.
    - raster3d: TRI / BEGIN_SCENE (0x25) / END_SCENE (0x26) routing and the
    SDRAM port switch. TRI outside a scene is drawn as a one-triangle
    scene over its bbox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
2026-10-25 G3 model: textured triangles in the reference model
    - raster.py: u, v (10.6 texel units) interpolated as attributes 4 and 5
    with the same setup; texel lookup for 16 / 8 / 4bpp (8 / 4bpp through
    the CLUT with an offset), wrap by mask, texel 0 is transparent,
    modulation by the vertex colour (128 = 1x, saturating).
    - gpu_model.py: SET_TEX (0x21) and CLUT_WRITE (0x28), textured TRI
    (flag bit1, one {v, u} word per vertex), scene triangles keep the
    texture that was current when they were submitted; set_tex / clut /
    upload_tex scenario steps.
    - scenarios/gpu3d/g3_tex.json: 16 / 8 / 4bpp, CLUT offset, wrap,
    transparency, modulation, Z, a cube and overdraw.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
2026-10-25 G3 RTL: textured triangles (SET_TEX, CLUT_WRITE, texture cache)
    - raster3d: SET_TEX (0x21, format / CLUT offset / log2 size + base) and
    CLUT_WRITE (0x28, two colours per word) are routed from the GPU; the
    current texture is latched into each binned triangle.
    - tri_engine: words are parsed as they arrive; the record grows to 32
    words (6 attributes, texture config and base).
    - tri_setup: 6 attributes (r, g, b, z, u, v); result destinations are
    re-encoded for the extra ranges.
    - tile_engine: pixel pipeline A-D. A computes the texel address and
    checks a 16-line x 8-word direct-mapped texture cache (a miss stalls A
    and fills one line); B picks the texel / CLUT index, C reads the CLUT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
2026-10-25 G3: harden paths that nextpnr does not time (DSP, DP BSRAM port B)
    The previous commit placed with a reported 92 MHz but drew wrong
    pixels on the board, and which pixels went wrong changed with the
    placement seed. nextpnr's Gowin timing model has no arcs for the DSP
    (MULT18X18), and the true-dual-port BSRAM's port-B address setup is
    added to the wrong cell type in gowin_arch_gen.py, so neither path is
    analysed or optimised. Every DP BSRAM here reads through port B. Its
    carry-chain delays also look optimistic: the 6 x 8 shift-and-add
    modulation failed on the board while reported as fitting.
    - smul36x18: the DSP gets two clocks (inputs held, product taken on
    the second); in_valid at most ev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
2026-10-25 G3 docs: texture commands, results, and the nextpnr timing gaps
    - SPECIFICATION 14: textured TRI, SET_TEX, CLUT_WRITE, texture rules
    (wrap, transparency, modulation, aligned base), the reduced 2D set
    of the 3D bitstream, updated speed figures.
    - GPU3D_PLAN: G3 results and deviations (no ISP / TSP split, 16-line
    cache, one CLUT, OR texel address, 2D trimmed), what placement and
    the board showed, measurements and resources.
    - CLAUDE.md: do not trust nextpnr's Fmax for DSP paths, DP BSRAM port
    B addresses and long carry chains; how to build around it.
    - README: G3 done.
2026-10-26 docs: pre-G4 review, process notes on timing-model blind spots
    - DEVELOPMENT_PROCESS.md を更新版に置き換え (配置の種で結果が変わるときの分岐、
    ALU と DFF の記録、ツールの死角の節)。BIST は実物の経路を通すこと、pre_G4_review を追加
    - pre_G4_review.md を追加 (消えた pre_K5_review へのリンクを直した)
    - RP2350-PiZero は入手できなくなったので、ホストの記述を Pico 2 に
2026-10-26 harness v2: Pico 2 instead of RP2350-PiZero
    - RP2350-PiZero は入手できなくなったので、Pico ピン配置 (Pico 2 / Pico Plus 2 / Pico LiPo 2) に
    載せ替えた回路図と配線表。PiZero の回路図は消した
    - CS と RESET のプルダウンを 4.7k に (RP2350-E9 で外付けは 8.2k 以下が要る)
    - HARNESS2.md のパスと Pi ヘッダの記述の残りを直した
2026-10-26 G4 model: semi-transparent TRI (4 blend modes) and the g4 scenarios
    - TRI のフラグ bit2 で半透明、[5:4] で式 (平均、加算、減算、1/4 加算。RGB565 の成分ごと)。
    Z はテストするが書かない。透明のテクセルは半透明でも描かない
    - シナリオの tri に "blend"。g4_semi (4 式、Z の奥、半透明どうしの重なり、テクスチャ + 変調、
    シーンの外の即時の半透明、画面全体の重ね塗り) と g4_fill_fps
2026-10-26 G4: blend stage in the tile engine
    - タイルの色を E 段で読み (半透明で混ぜる相手)、F 段で混ぜ、G 段で書く (書くデータは FF から)。
    Z は F 段のまま、半透明は書かない
    - レコードの 1 ワード目のフラグから半透明と式を取る (tri_engine はもともと 8bit 全部を記録している)
    - シーンの外の TRI は描く面のタイルを読んでから描くので、即時でも描く面と混ざる
    - tb_raster3d に半透明 (4 式、飽和、Z の奥、2 回重ね)
2026-10-26 harness: expect the error bit where the model overflows a tile list
    - G3 で wait_idle がエラーのビットを読み捨てなくなったので、g2_tbdr の check 7 (1 タイルに 1,101 個、
    わざと溢れさせる) がエラーで不合格になっていた (G3 の確かめで見落とした)。
    モデルがシーンとタイルのリストの溢れでエラーを立て、ハーネスは check ごとに「立つはずか」と比べる
    - g3_tex の check 4 (画面全体が 1 ピクセルの色の乱数) はキャプチャの 4:2:2 で一致率 0 になる。
    CRC は一致し、見た目も同じなので capture_min を 0 に (正しさは CRC で見る)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
2026-10-26 G4 docs: semi-transparency rules, results and worst-case numbers
2026-10-26 G5: host-side 3D pipeline and four scenes (logo, tunnel, room, city)
    - demo3d.py: カメラ、視錐台とガードバンドでのクリップ、裏面を捨てる、頂点の明るさと霧、環境マップ、
    奥から手前への並べ替え (Z は要るところだけ)、手続きのテクスチャ
    - 場面: TANG のロゴ (Z、金の環境マップ、加算の光の帯)、曲がるトンネル (霧、加算の光の輪)、
    映り込む玉の部屋 (床の下に写して床を平均で重ねる、減算の影)、夜の街 (窓のテクスチャ、街灯)
    - フレーム k のコマンドは k だけで決まる。gpu_model に demo3d_setup / demo3d_frame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
2026-10-26 harness: demo <scene> streams a G5 3D scene, --shot saves a capture
    - 3D の場面はリンク (ハーネス v1 の SPI) で遅くなるので、60fps で間に合うかは見ない
2026-10-26 G5: g5_scenes scenario and a texture-cache simulator
    - g5_scenes: 4 つの場面の 5 フレームをモデル = Verilator = 実機で比べる
    - texcache_sim.py: 場面のテクセルの取り出しをハードと同じ順に並べ、キャッシュの当たりを見積もる
    (今の 16 行で Verilator の tex_miss と同じ数)。行の数と 4 x 4 のかたまりの並びを比べる
2026-10-26 harness bridge v3: stream command (flow control on the bridge, SPI by DMA)
    - stream <n> <port> <free>: ブリッジが空き (GPU_FREE) を SPI で読みながら CMD に流す。USB の往復は 1 回。
    SPI は DMA で送り、そのあいだに次の 2KB を USB から受け取る。番地はホストが渡す (ブリッジは意味を知らない)
    - USB CDC: 受け取りの 1 回の転送を 512 バイトに、USB のタスクを 100us ごとに (既定の 64 バイト / 1ms が律速だった)
    - Gpu.send は v3 なら stream を使う
    - 256KB の NOP: 206KB/s → 764KB/s (SPI 8MHz でも 10.4MHz でも同じ。USB のフルスピードの CDC が律速)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
2026-10-26 harness: READY selftest scales with the FIFO depth and runs at 8MHz
    - 埋める量を FIFO の深さ (GPU_FREE) の 6 割に、待ちを約 4 フレームに。1MHz のままだと送り終わる前に待ちが明ける
2026-10-27 3D bitstream: drop the SDRAM BIST (keep single-word read/write)
    - mem_test に BIST パラメータ。0 なら BIST を外し、1 ワードの読み書き・取り込み位置・位相のレジスタは残す。
    MEM_STATUS bit4 = BIST なし。3D GPU のビットストリームは BIST = 0 (DFF -152、LUT + ALU -439)
    - selftest の SDRAM の位相の余裕は BIST がなければ飛ばす (sdram_ctrl と設定は VDP と同じなので VDP のビットストリームで見る)。
    memtest は BIST がなければエラーにする
2026-10-27 tri_engine: the tile-count RAM takes its addresses and data from FFs
    - cnt は真のデュアルポートの BSRAM (DPX9B)。nextpnr は B ポートの番地 (ADB) のタイミングを見ない
    (gowin_arch_gen.py が ADB を別の種類のセルに登録している)。読み出しの番地は tile_engine の ty * 10 + tx と
    btile の選択の論理、書き込みは番地の選択と cnt_q + 1 だった
    - 読み出しの番地を 1 段 FF に置き (cnt_q は番地の 2 クロック後、E_BCNT2 を足した)、書き込みも番地とデータを FF に置く
2026-10-27 tile_engine: tile buffers take their addresses and data from FFs
    - 色と Z のタイルバッファ (DPX9B) の読み出しの番地は、走査の段と書き出しの {行, ワード} の選択の論理、
    書き込みは消す・読み込む・書き出しで消す・ピクセルの 4 つの選択だった (G2 から)
    - 読み出しの番地は 1 段 FF に (Z は次に C 段に入るピクセル、色は次に E 段に入るピクセル、どちらもなければ書き出し)。
    ピクセルの読み出しの時刻は変わらない。書き出しは読んだワードが 2 クロック後に出るので FIFO を 3 ワードに
    - 書き込みは印・番号・データを FF に置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
2026-10-27 tri_setup: keep the setup results in a 32-word SDP RAM instead of FFs
    - e, s, gx, gy (辺の値、属性の左上の値と増分) をレコードと同じ番号の RAM (rec、SDP の BSRAM 1 個) に書く。
    S_OPS3 の乗算の gx / gy は前のクロックに rec から読む (乗算は 2 クロックに 1 回なので間に合う。S_DRAIN のあいだ k = 0)
    - tri_engine はレコードの 3..5、12..29 を rec から読む (mem_wnext で進む前に次の番号を出す)。32 ワードの選択がなくなる
    - SDP の BSRAM は nextpnr が番地もデータもタイミングを見る (見ないのは真のデュアルポートの B ポートの番地だけ)
    - DFF 6,810 → 6,209、BS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
2026-10-27 3D bitstream: 2,048-word command FIFO
    - END_SCENE のタイルのパスのあいだも次のフレームのコマンドを受けられるように (512 ワードだとすぐ満杯になり、
    リンクが止まって転送と描画が重ならなかった)。VDP は 512 のまま
    - 番地は rd_ptr / wr_ptr の FF から直接
2026-10-27 tile_engine: register the texel word address (computed a clock ahead)
    - テクセルのワードアドレス (taddr) を FF に。次のクロックに A 段にいるピクセルの u, v (ac の更新と同じ加算器) から作る
    - キャッシュの判定、埋める行の番地 (mem_addr)、行 (tf_line)、タグ (tf_tag)、キャッシュの読み出しの番地がどれも同じ FF から出る。
    組み合わせのワードアドレスから同じクロックに 3 つを取っていたら、FIFO を大きくして配置が変わったとき、
    1 行がほかの行のデータで埋まった (nextpnr の報告では間に合っていた)
    - 振る舞いは同じ (Verilator の外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
2026-10-27 tile_engine: keep the cache tags in FFs
    - ワードアドレスを FF にしたら、yosys が ttags (組み合わせで読む 16 x 14bit) を真のデュアルポートの BSRAM にし、
    番地の FF を取り込んで FF の D 入力 (論理) を番地にした。nextpnr はその番地を見ない。ram_style = "logic" で FF に
2026-10-27 build: check that true dual-port BSRAM addresses come straight from FFs
    - scripts/bsram_check.py: 合成したネットリストで、DPX9B の ADA / ADB の全ビットが FF の Q か定数で駆動されているかを見る。
    yosys が番地の FF を RAM に取り込むと RTL を見ても分からないので、ネットリストで見る
    - TARGET=gpu3d は違反で止める (今は 11 個、違反 0)。VDP は報告だけ (479 ビット。混んでいないので今は実機で問題が出ていない)
2026-10-27 docs: placement robustness (DP BSRAM addresses, bsram_check), LUT4 includes ALU
    - CLAUDE.md: nextpnr が見ないのは DP の BSRAM の B ポートの番地 (SDP は見る)、yosys の番地の取り込み、bsram_check、完了は 2 つ以上の種
    - GPU3D_PLAN: G5 のあと (配置に強くする) の結果。G3 の「LUT4 に ALU は入っていない」を訂正
    - DEVELOPMENT_PROCESS: 同じ訂正。SPECIFICATION: 3D の FIFO 2,048 ワード、BIST なし。HARNESS: memtest
2026-10-28 kicad v2
2026-10-28 harness v2: connect COPI and Tang GND pin 26, sync docs with board
    - Schematic/PCB: wire Pico pin 15 (GP11, SPI1 TX) to COPI (FPGA 19),
    tie Tang pin 26 to GND
    - HARNESS2.md / pins_v2.json: new schematic path, reference designators
    (series R4-R8, pull-downs R9/R10, JP1 = VSYNC, JP2 = HEARTBEAT),
    drop the optional 5V line (JP1 + SS14) that v2 removed
2026-10-28 tile_engine: 64-line texture cache with tags in an SDP BSRAM
    - 16 行 → 64 行 (データは 512 ワードで BSRAM 1 個のまま)。G5 の場面の当たり: tunnel 70.0 → 96.4%、room 74.4 → 92.9%、
    city 72.1 → 83.4% (texcache_sim.py の見積もりと同じ)。1 フレームのクロック: tunnel 846K → 509K、room 944K → 611K、city 1,681K → 1,410K
    - タグは BSRAM。A 段のピクセルのタグが同じクロックに出ているように taddr の D 入力 (次のピクセル) で読む。番地が論理になるので SDP にする
    (19bit = {~タグの下位 7bit, タグ}。DP は 18bit までなので SDP になる。両方を比べるので yosys が幅を削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
2026-10-28 harness v2: move VSYNC to DDC_CLK (52), drop HEARTBEAT and jumpers
    - KiCad: VSYNC Pico pin 29 -> Tang 52 (HDMI DDC_CLK, 2.2k pull-up to 3.3V),
    direct trace. JP1/JP2 and the HEARTBEAT line removed
    - HARNESS2.md / pins_v2.json: 12 signals. HEARTBEAT only mirrored VSYNC
    (both stop in reset), so ready is judged from VSYNC edges. 15-18 are free
    for LCD_INIT; 76 stays unused (BL616 JTAG MOSI)
2026-10-28 Texture layout: 8-word blocks (4x4 texels for 16bpp) instead of rows
    - テクスチャの並びをキャッシュの 1 行 (8 ワード) ごとのかたまりに: 16bpp は 4 x 4 テクセル、8bpp は 4 x 8、4bpp は 8 x 8。
    かたまりは左上から行ごと (raster.py の tex_index)。最小の大きさ 8 x 8 にどれも収まる
    - モデル (raster.py、gpu_model の upload_tex)、demo3d のアップロード、tile_engine のワードアドレス、tb_raster3d、仕様を一緒に変えた
    (並びとアップロードが両方変わるので、どのシナリオも絵の CRC は前と同じ)
    - 当たり (64 行): tunnel 96.4 → 98.0%、room 92.9 → 94.7%、city 83.4 → 88.2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
2026-10-28 docs: HARNESS2 board check (nets, HSTX lengths) and v2 bring-up list
    - 基板のネットを確かめた結果 (12 本の信号のピン、GND、3V3 は Pico 側だけ、HSTX の配線長と差)
    - DDC_CLK を使うので EDID は読めないこと、v2 で動かすときに変えるもの (ファームウェア、FPGA の制約、harness.py)
2026-10-28 make demo: SCENE= runs a G5 3D scene; FRAMES defaults to 0 as documented
    - SCENE=logo|tunnel|room|city で harness.py demo <場面> (3D のビットストリーム)
    - FRAMES ?= 0 は前の FRAMES ?= 3 (make render) に負けて、make demo が 3 フレームで止まっていた。コマンドラインで指定したときだけ使う
2026-10-28 harness demo: check the bitstream (VERSION bit7) before streaming
    - 3D の場面を VDP のビットストリームに流すと GPU が止まって「GPU stays busy」になっていた。
    始める前に VERSION を見て、どの make prog が要るかを出す
2026-10-29 docs: pre-G6 review with corrections (scan counts, ISP needs Z, PIO, nextpnr not apicula)
    - city の 63 万 → 22 万は全部が外接矩形の空振り (重ね描きは 22 万に入っている)。走査の数 (今 / 安い版 / 正確な端) の表
    - ISP / TSP は今の場面 (Z なし) には効かない。PARLIO → PIO、FIFO は BSRAM +3、ADB の不具合は nextpnr、DDC のプルアップの食い違い
2026-10-29 docs: nextpnr Gowin timing blind spots (ADB arcs on the SP variant, post-route path loss)
    - NEXTPNR_GOWIN_TIMING.md: DP の ADB の弧が sp に登録されている (ソースの行、直し方)、eb4f15c3 の DOB の名前、
    配線のあとの解析が 30 段の組み合わせを落とす観測 (配置のあと約 12MHz → 配線のあと 175〜320MHz、FF で受けても)、上流への報告の下書き
    - 最小の再現 tools/repro/nextpnr_gowin_timing/ と make timing-repro
    - CLAUDE.md: 配置のあとの Max frequency も見る
2026-10-29 tile_engine: skip rows outside the triangle and stop a row after leaving it
    - 行の始めで、どれかの辺が重なりの行の両端で負ならその行を走査しない (辺の値は x について 1 次)。右端の値 er_end は
    組ごとの乗算に 6 回足して作り (レコードの e が er にあるうちに先に出す)、行ごとに er と一緒に進める
    - 行の中で中のピクセルを出したあと外に出たら、その行を終える (三角形は凸)
    - 行の終わりの 2 状態 (T_DRAIN / T_DRAIN2) を 1 つに
    - 1 フレームのクロック: city 1,280K → 960K (GPU だけで約 66fps)、tunnel 490K → 370K、room 573K → 455K、logo 369K → 290K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
2026-10-29 docs: span skipping results (city fits a 60 Hz frame GPU-side)
2026-10-29 demo: roofs on the city buildings, SCENE=all cycles the 3D scenes every 10 s
    - 屋上は向きが逆で、いつも裏として捨てられていた。表を上に向け、上からの光と霧の単色に (1 枚 2 三角形、単色でリンクの量を抑える)
    - make demo SCENE=all / harness.py demo all: logo → tunnel → room → city を 10 秒ずつくり返す。テクスチャは全部の場面の分を最初に送り、
    場面ごとにフレーム 0 から。切り替えは時計で決める
    - g5_scenes の city のフレームの期待値も屋上込みになる (モデルが demo3d から作る)
2026-10-29 tile_engine: two-stage accumulate for the per-pair corner values
    - 組ごとの乗算の足し算 (3 つから選んだ相手 + 積、32bit) を 2 段に: 1 段目で相手と積を FF に、2 段目で足して置く。
    積は 2 クロックに 1 つなので、次の積の 1 段目には macc が間に合う。組あたり +1 クロック
    - 屋上の入った city のフレームで、既定の種の配置だけ 1 行 (3 ピクセル) が欠けた (種 7 は合う、Verilator も合う)。
    #45 で選ぶ相手を 2 つから 3 つにした経路。nextpnr の報告では間に合っていた
2026-10-30 RECONFIG register: the design pulls its own RECONFIG_N (pin 9) low
    - vdp_regs: 0x7C RECONFIG。0xA5 を書くと 1 クロックの要求 (ほかの値は何もしない)。tb_vdp_regs で確かめる
    - top: 要求で RECONFIG_N (ピン 9) を 256 クロック Low にする。ピン 9 はヘッダに出ていない (基板の TP1 だけ) が、設計の出力で駆動できる
2026-10-30 build: multiboot images (VDP at 0x000000, 3D GPU at 0x100000) pointing at each other
    - gowin_pack --multiboot_address で、それぞれ相手の番地を「次のビットストリーム」に。make flash は TARGET ごとの番地に書く
    - --reconfign_as_gpio は付けない: 付けるとピンが GPIO になって Low にしても再コンフィグしない (実機で確かめた)
2026-10-30 harness: reconfig command (switch bitstreams and time it)
2026-10-30 docs: RECONFIG register, bitstream switching (no harness wire needed)
2026-10-30 make: drop TARGET; bitstream/flash handle the VDP + 3D pair, per-design rules
    - 設計ごとの変数 (vdp / gpu3d / lcd / probe) と、合成・配置配線・ビットストリーム・pincheck の規則を define で作る。成果物は build/<設計>/
    - make bitstream は VDP と 3D GPU の両方、make bitstream-<設計> で 1 つ。make prog (VDP) / prog-3d / prog-lcd / prog-probe
    - make flash は VDP (0x000000) と 3D GPU (0x100000) の組を書く
    - make scenario は scenarios/gpu3d/ のシナリオを 3D GPU の構成で走らせる。make render-lcd で 800x480
    - TARGET= を渡すと、新しい書き方を出して止まる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
2026-10-30 harness: switch to the needed bitstream automatically (RECONFIG)
    - demo (3D の場面は 3D GPU、M9 は VDP) と scenarios/gpu3d/ のシナリオ・fps は、要るビットストリームが動いていなければ RECONFIG で切り替える
    (結果に switched)。2D のシナリオは今のビットストリームのまま (3D GPU の上で 2D を確かめられるように)
    - prog <vdp|gpu3d|lcd|probe>
2026-10-30 docs: new make targets (no TARGET), automatic bitstream switching
