fpt/tang-verilog/(notices)

Notices in the files:
harness/kicad/v1/rp-tang-harness.kicad_pcb:
(c) 2026 Youichi Fujimoto
